senmag-robotics/Mantis-Desktop/partsList.ods

Part reference | Quantity | Description | Self-procurement method | Procurement details | Material | Source (Github) | Link
Motor | 3 | Brushless DC Motor. Produces Torque | Purchase (Link) | Ali express, X8308S | NA | None | https://senmag-robotics.com/mantis/mantis-desktop/partlib/motor
Encoder | 3 | Measures the angle of a magnet | Manufacture PCB (source) and purchase Encoder chip (Link) | Info in source location | NA | TBA | https://senmag-robotics.com/mantis/mantis-desktop/partlib/encoder
Encoder magnet | 3 | Attached to motor, allows encoder to measure angle of motor. | 3D print (source) and add magnets (Link) | Layer height = 0.1mm | PLA | Source/CAD/encoderMagnet.stl | https://senmag-robotics.com/mantis/mantis-desktop/partlib/encodermagnet
Main controller | 1 | Main electronic controller | Manufacture PCB (source) | Info in source location |  | TBA
Sensor Controller | 1 | Electronic controller for the force sensor | Manufacture PCB (source) | Info in source location |  | TBA
Force sensor | 1 | Force sensor – measures force output in 3D | Manufacture PCB (source) | Info in source location |  | TBA
Bolt M3 15mm countersunk | 15 |  | Purchase (Link)
Bolt M3 15mm Cap | 20 |  | Purchase (Link)
Bolt M3 22mm countersunk | 4 |  | Purchase (Link)
Bolt M4 10mm Cap | 6 |  | Purchase (Link)
Bolt M4 16mm Cap | 18 |  | Purchase (Link)
Bolt M4 12mm countersunk | 3 |  | Purchase (Link)
Bolt M4 25mm Cap | 2 |  | Purchase (Link)
Bolt M5 18mm Cap | 3 |  | Purchase (Link)
Nut M3 Nyloc | 12 |  | Purchase (Link)
Nut M4 Nyloc | 2 |  | Purchase (Link)
Nut M5 Nyloc | 3 |  | Purchase (Link)
Part A | 2 | The base sections of the robot, designed to clamp onto a table edge. | 3D print (source) | Layer height = 0.2mm | PLA | Source/CAD/part_a.stl
Part B | 1 | The top panel for the base | Lasercut (source) |  | Steel / Aluminium (3mm) | Source/CAD/part_b.dxf
Part C | 1 | The front panel for the base | Lasercut (source) |  | Delrin 4mm | Source/CAD/part_c.dxf
Part D | 1 | The shoulder pivot bracket | Lasercut + bend (source) |  | Steel / Aluminium (3mm) | Source/CAD/part_d.dxf
Part E | 1 | The shoulder section of the arm | Lasercut (source) |  | Delrin / Acrylic 8mm | Source/CAD/part_e.dxf
Part F | 1 | The first stiffening brace for part E | Lasercut (source) |  | Delrin / Acrylic 8mm | Source/CAD/part_f.dxf
Part G | 1 | The second stiffening brace for pare E | Lasercut (source) |  | Delrin / Acrylic 8mm | Source/CAD/part_g.dxf
Part H | 1 | The elbow section of the arm | Lasercut (source) |  | Delrin / Acrylic 6mm | Source/CAD/part_h.dxf
Part I | 1 | The parallel link section of the arm | Lasercut (source) |  | Delrin / Acrylic 6mm | Source/CAD/part_i.dxf
Part J | 1 | The end section of the arm | Lasercut (source) |  | Delrin / Acrylic 8mm | Source/CAD/part_j.dxf
Part K | 1 | Stiffening brace for part J | Lasercut (source) |  | Delrin / Acrylic 8mm | Source/CAD/part_k.dxf
Part L | 1 | Attachment for the force sensor | 3D print (source) | Layer height = 0.2mm | PLA | Source/CAD/part_l.stl
Part M | 2 | Washer plate for the force sensor | Lasercut (source) |  | Delrin 2mm | Source/CAD/part_m.dxf
Part N | 6 | Washer plate for the force sensor | Lasercut (source) |  | Delrin 2mm | Source/CAD/part_n.dxf
Part O | 1 | End cap of the force sensor | 3D print (source) | Layer height = 0.2mm | PLA | Source/CAD/part_o.stl
Part P | 1 | Centre pin to make axle between motors | Purchase (Link) or Lathe (source) |  | Steel / Aluminium | Source/CAD/part_p.dxf | https://senmag-robotics.com/mantis/mantis-desktop/partlib/centrepin
Part Q | 1 | The panel that the main controller is attached to | Lasercut (source) |  | Delrin 4mm | Source/CAD/part_q.dxf
Part R | 3 | Spacer for the encoders | Lasercut (source) |  | Delrin 4mm | Source/CAD/part_r.dxf
