senmag-robotics/Mantis-Desktop/Source/CAD/part_e.dxf

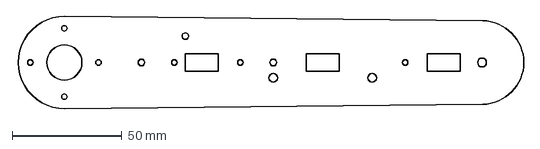
[picture p1: CAD file, 2019-07-10]
Source/CAD/part_e.dxf
231.0 x 42.2 mm
