senmag-robotics/Mantis-Desktop/Source/CAD/part_h.dxf

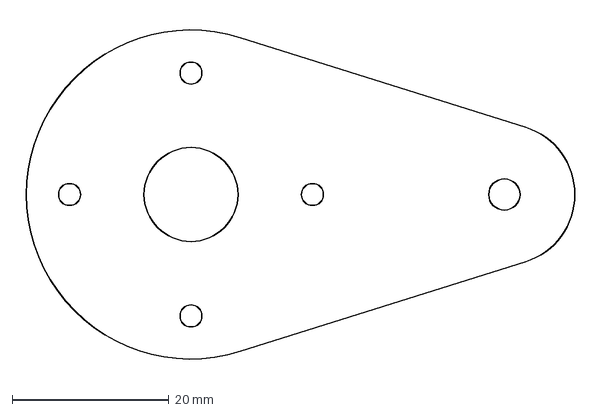
[picture p2: CAD file, 2019-07-10]
Source/CAD/part_h.dxf
71.3 x 45.5 mm
