senmag-robotics/Mantis-Desktop/Source/CAD/part_g.dxf

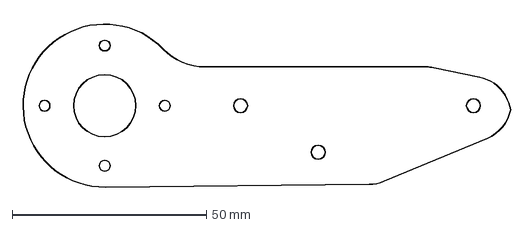
[picture p3: CAD file, 2019-07-10]
Source/CAD/part_g.dxf
127.4 x 44.1 mm
