senmag-robotics/Mantis-Desktop/Source/CAD/part_n.dxf

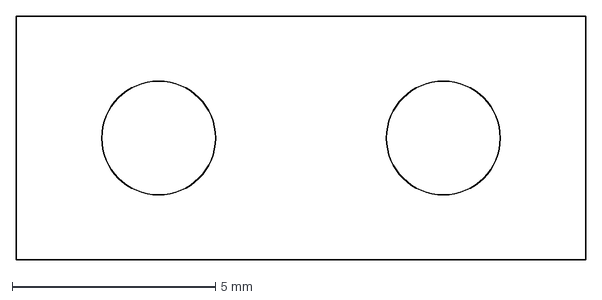
[picture p4: CAD file, 2019-07-10]
Source/CAD/part_n.dxf
14.0 x 6.00 mm
