senmag-robotics/Mantis-Desktop/Source/CAD/part_p.dxf

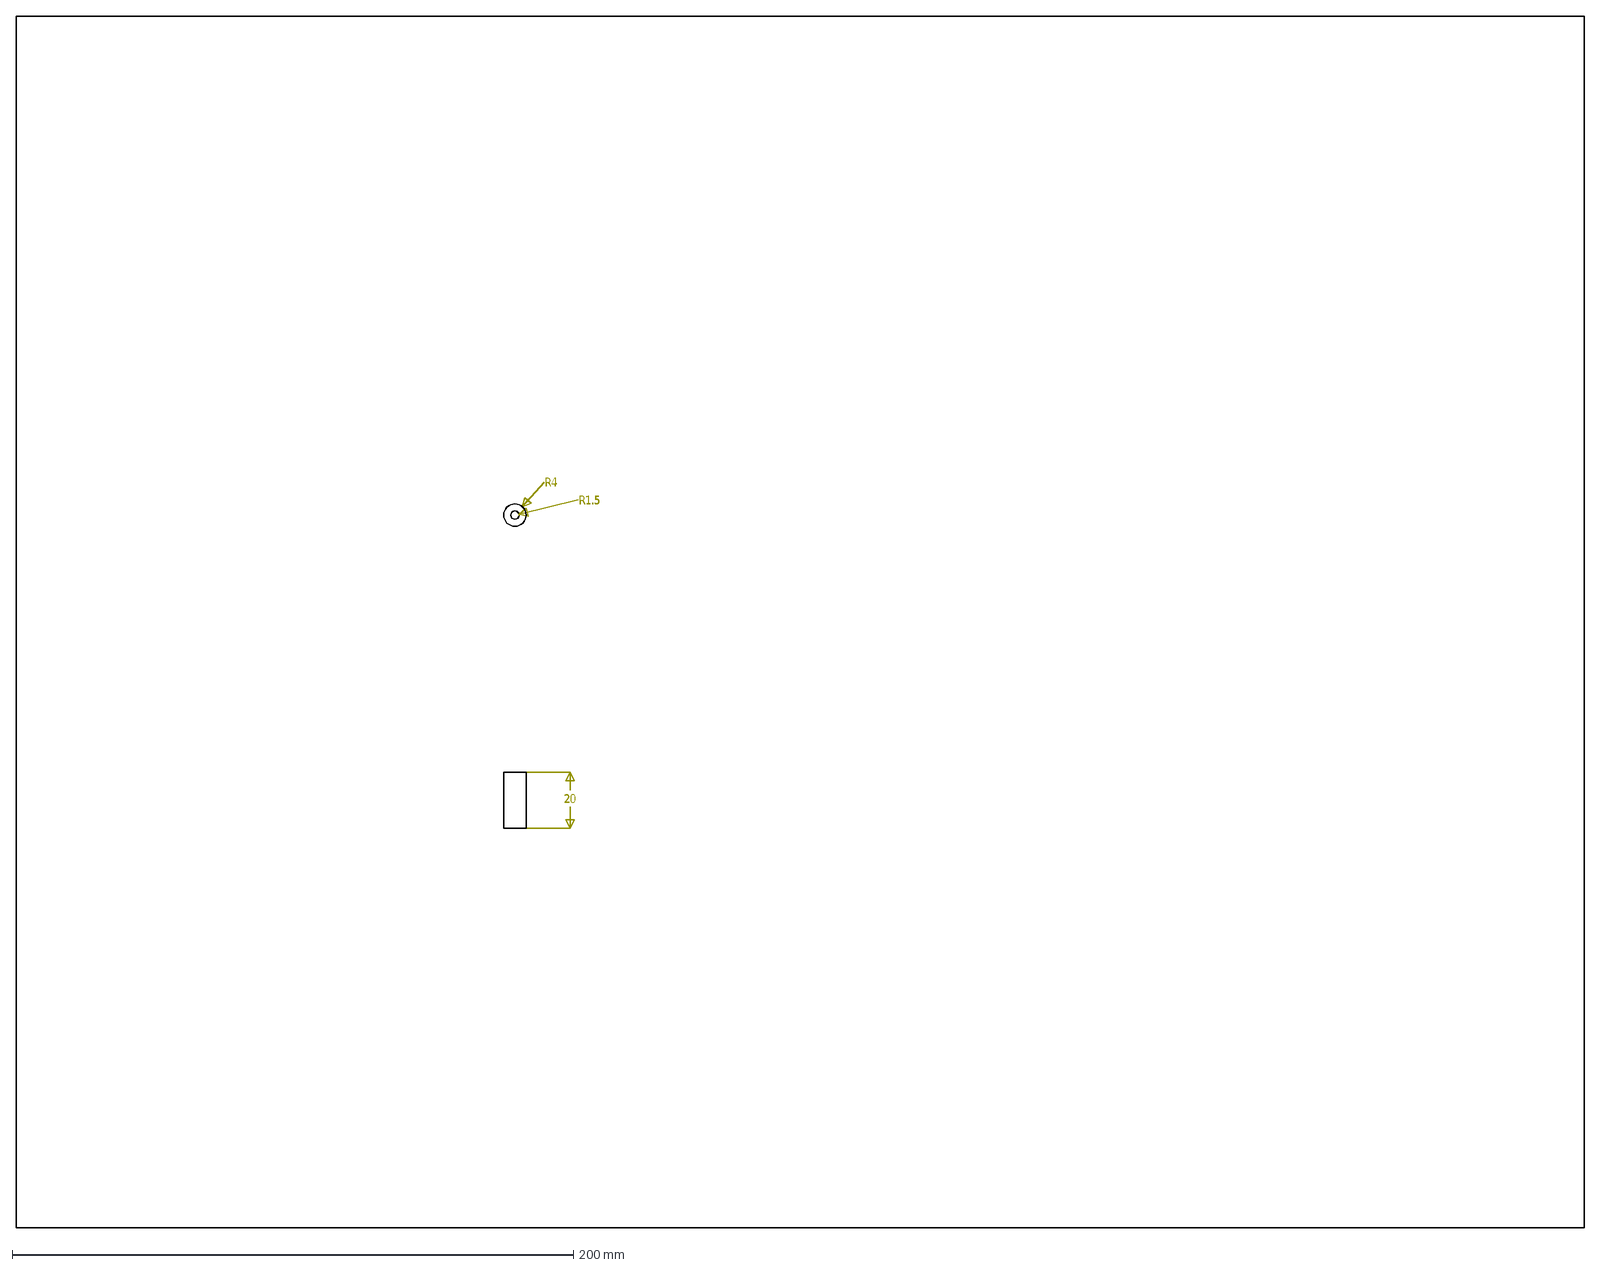
[picture p5: CAD file, 2019-07-10]
Source/CAD/part_p.dxf
R4
R1.5
20
