senmag-robotics/Mantis-Desktop/Source/CAD/part_f.dxf

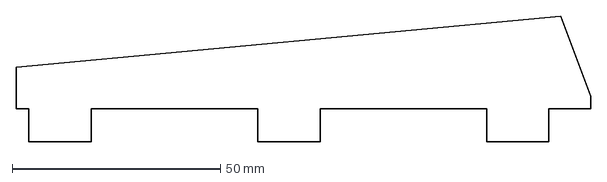
[picture p6: CAD file, 2019-07-10]
Source/CAD/part_f.dxf
138.0 x 30.3 mm
