senmag-robotics/Mantis-Desktop/Source/CAD/part_c.dxf

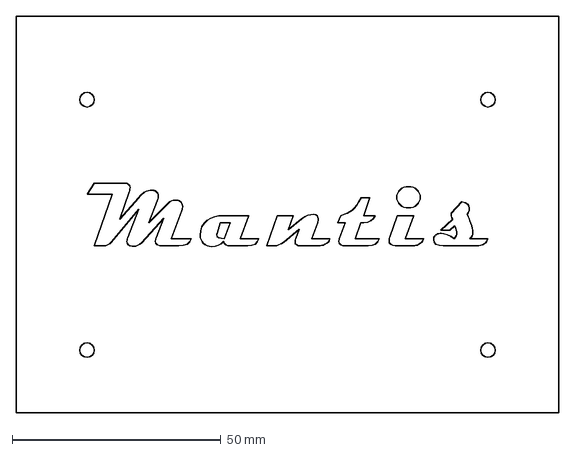
[picture p7: CAD file, 2019-07-10]
Source/CAD/part_c.dxf
130.0 x 95.0 mm
