senmag-robotics/Mantis-Desktop/Source/CAD/part_o.stl

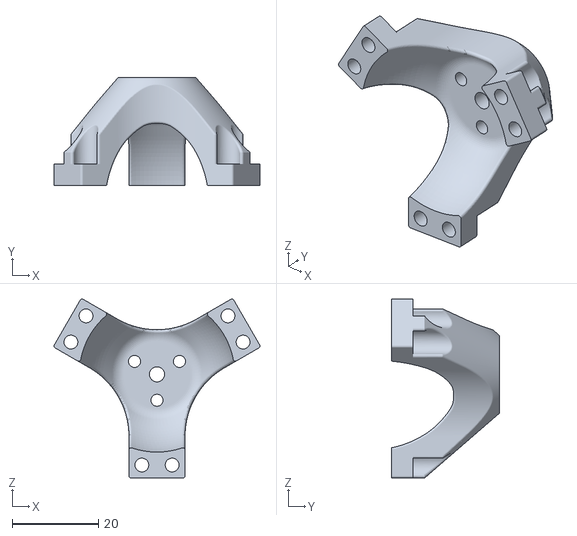
[picture p8: CAD file, 2019-07-10]
Source/CAD/part_o.stl
47.7 x 25.0 x 41.4
