senmag-robotics/Mantis-Desktop/Source/CAD/part_r.dxf

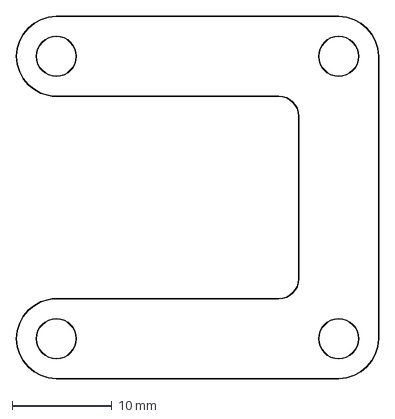
[picture p9: CAD file, 2019-07-10]
Source/CAD/part_r.dxf
36.3 x 36.3 mm
