senmag-robotics/Mantis-Desktop/Source/CAD/part_b.dxf

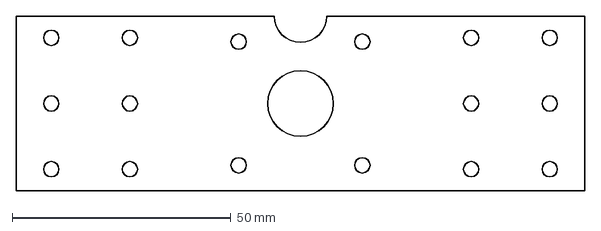
[picture p10: CAD file, 2019-07-10]
Source/CAD/part_b.dxf
130.0 x 40.0 mm
