senmag-robotics/Mantis-Desktop/Source/CAD/part_i.dxf

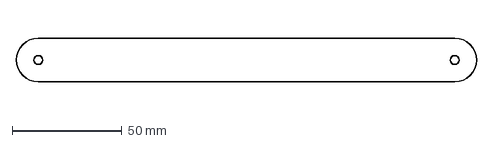
[picture p11: CAD file, 2019-07-10]
Source/CAD/part_i.dxf
210.0 x 20.0 mm
