senmag-robotics/Mantis-Desktop/Source/CAD/part_j.dxf

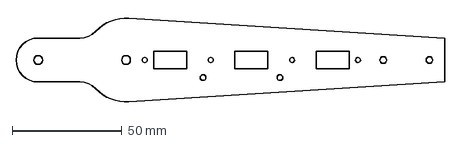
[picture p12: CAD file, 2019-07-10]
Source/CAD/part_j.dxf
195.0 x 38.6 mm
