senmag-robotics/Mantis-Desktop/Source/CAD/encodermagnet.stl

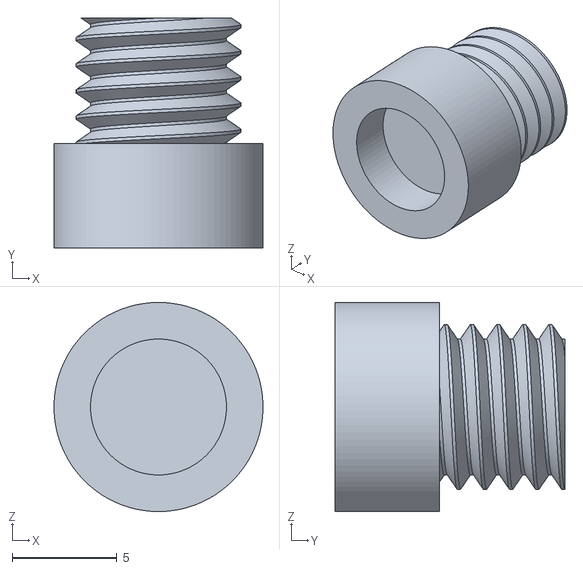
[picture p13: CAD file, 2019-07-10]
Source/CAD/encodermagnet.stl
9.99 x 11.0 x 10.0
