senmag-robotics/Mantis-Desktop/Source/CAD/part_k.dxf

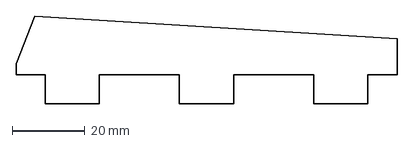
[picture p14: CAD file, 2019-07-10]
Source/CAD/part_k.dxf
105.0 x 24.2 mm
