senmag-robotics/Mantis-Desktop/Source/CAD/part_l.stl

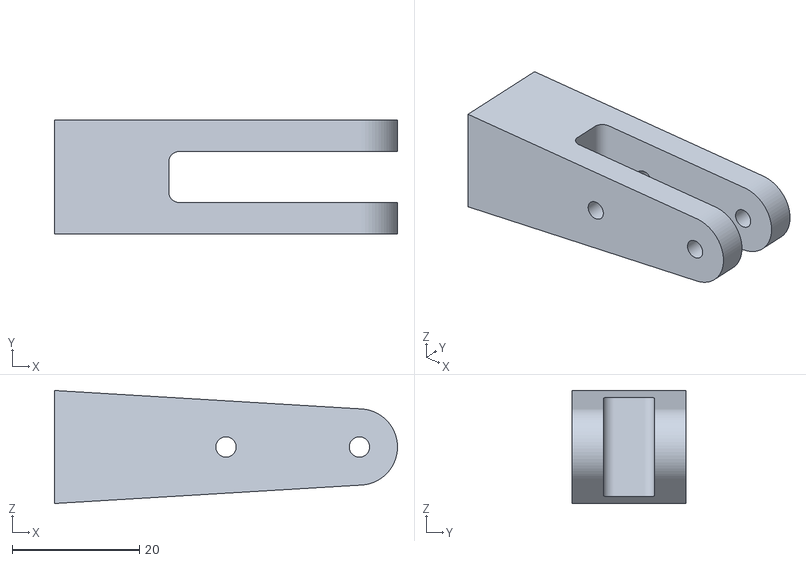
[picture p15: CAD file, 2019-07-10]
Source/CAD/part_l.stl
54.0 x 18.0 x 17.8
