senmag-robotics/Mantis-Desktop/Source/CAD/part_m.dxf

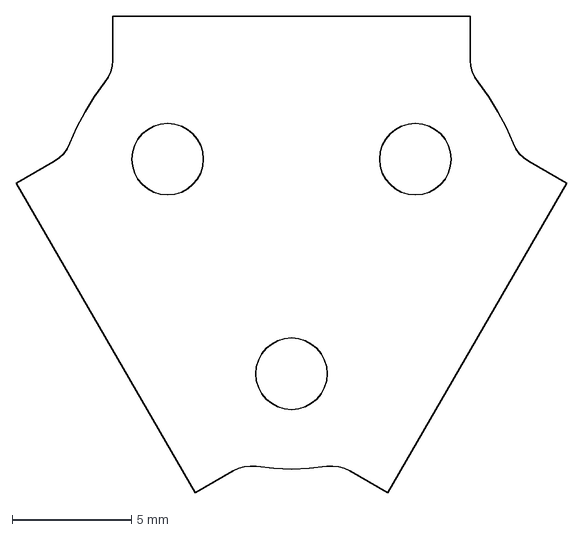
[picture p16: CAD file, 2019-07-10]
Source/CAD/part_m.dxf
23.1 x 20.0 mm
