senmag-robotics/Mantis-Desktop/Source/CAD/part_a.stl

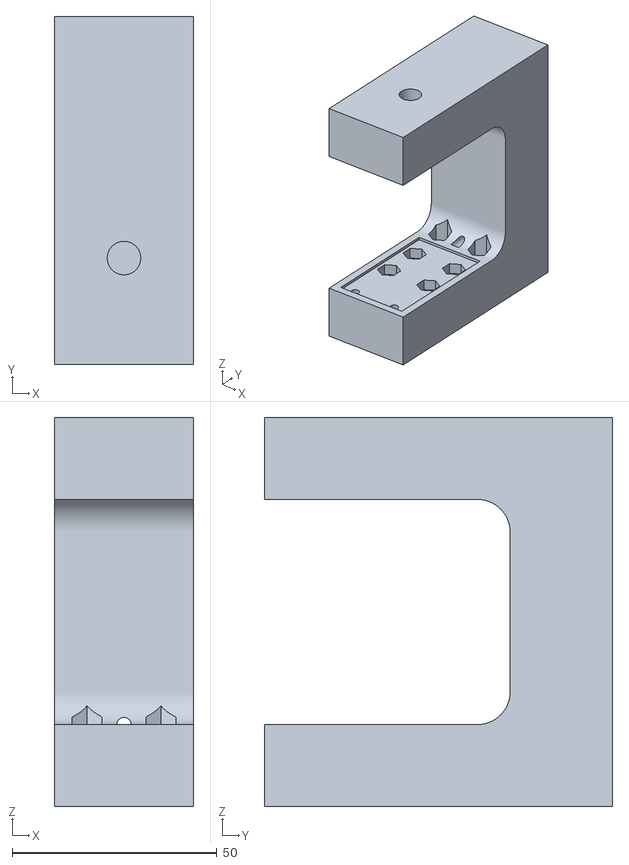
[picture p17: CAD file, 2019-07-10]
Source/CAD/part_a.stl
34.0 x 85.0 x 95.0
