senmag-robotics/Mantis-Desktop/Source/CAD/part_d.dxf

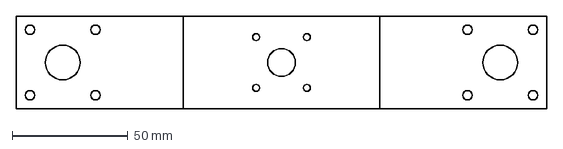
[picture p18: CAD file, 2019-07-10]
Source/CAD/part_d.dxf
229.0 x 40.0 mm
