senmag-robotics/Mantis-Desktop/MantisDesktop_AssembleyGuide.pdf

# Mantis Desktop Assembly Guide

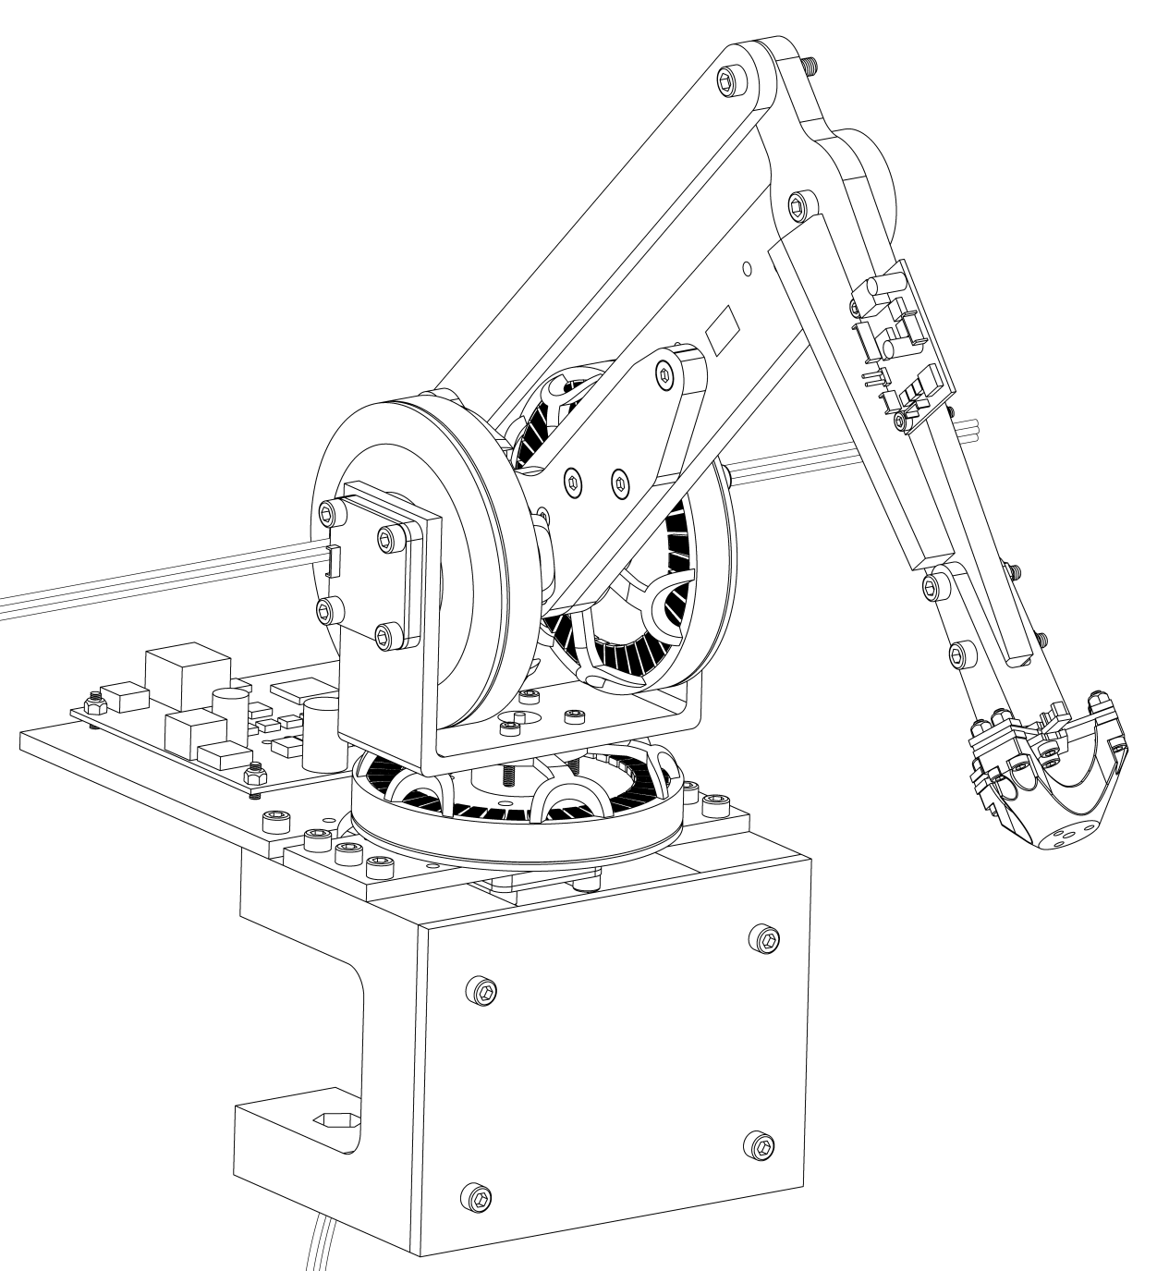
[picture p19: figure]

# Version 1.0

Written by Gareth Barnaby

## Table of Contents

## Introduction:

This document contains instructions for assembling the open source Mantis desktop haptic robot. The most recent version of this document along with the source materials can be found on our GitHub: (https://github.com/senmag-robotics/Mantis-Desktop/).

This document contains visual instructions for assembling a Mantis desktop from pre-fabricated parts. General information on fabricating / purchasing the necessary parts can be found in the “PartFabrication.ods” file in the GitHub, and more detailed information including CAD files can be found in the Source/CAD folder.

The next section in this document is the part index. This lists all of the major components needed to assemble the mechanics of the Mantis-mini. This is followed by sections of step-by-step instructions to assemble the parts. Connecting the electronics and uploading firmware will be covered by a separate document.

## Part index:

Part reference | Quantity in kit | Description | Image

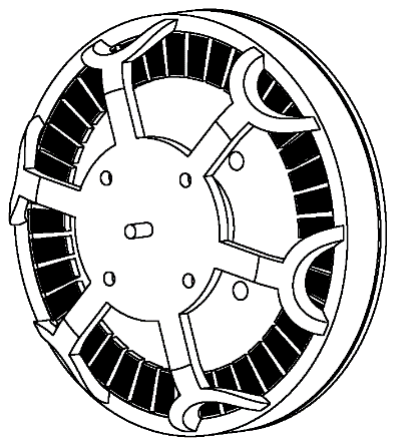
[picture p20: figure]

Motor | 3 | Brushless DC Motor. Produces Torque

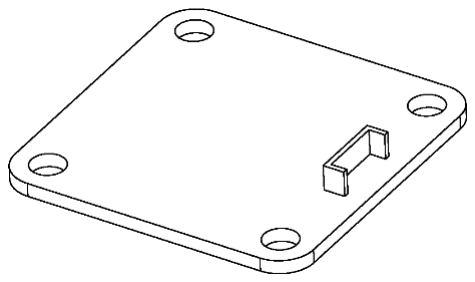
[picture p21: figure]

Encoder | 3 | Measures the angle of a magnet

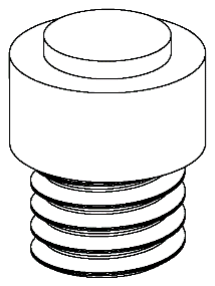
[picture p22: figure]

Encoder Magnet | 3 | Attached to motor, allows encoder to measure angle of motor.

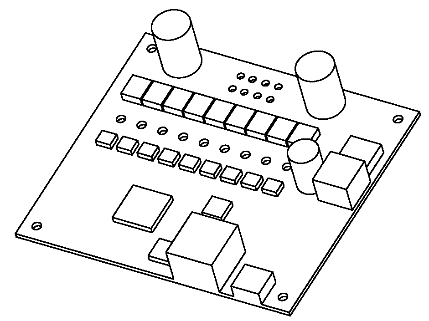
[picture p23: figure]

Main Controller | 1 | Main electronic controller

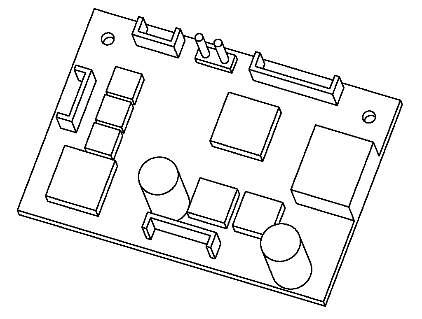
[picture p24: figure]

Sensor Controller | 1 | Electronic controller for the force sensor

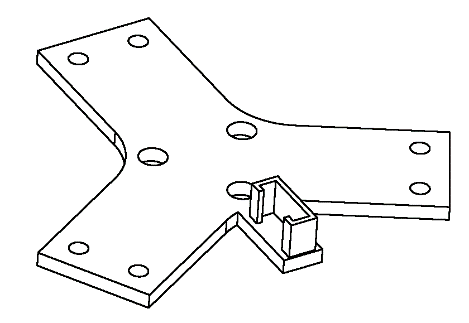
[picture p25: figure]

Force Sensor | 1 | Force sensor – measures force output in 3D
Bolt (M3 15mm countersunk) | 15
Bolt (M3 15mm cap) | 20
Bolt (M3 22mm countersunk) | 4
Bolt (M4 10mm cap) | 6
Bolt (M4 16mm cap) | 18

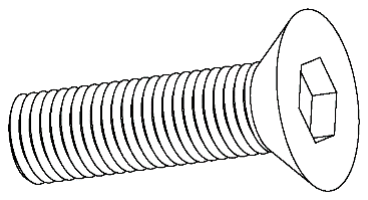
[picture p26: figure]

Bolt (M4 12mm countersunk) | 3

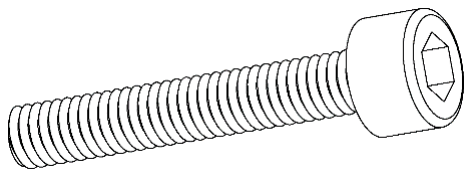
[picture p27: figure]

Bolt (M4 25mm cap) | 2

Bolt (M5 18mm cap) | 3
Nut M3 Nyloc | 12
Nut M4 Nyloc | 2

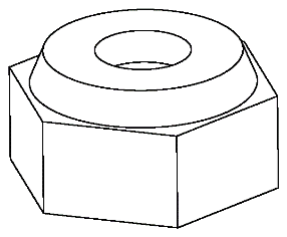
[picture p28: figure]

Nut M5 Nyloc | 3

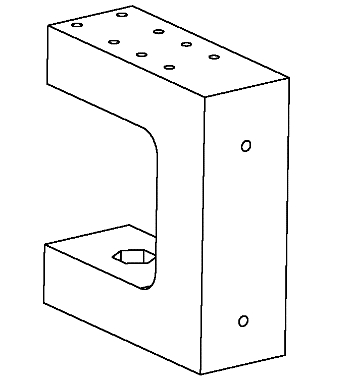
[picture p29: figure]

Part A | 2 | The base sections of the robot, designed to clamp onto a table edge.

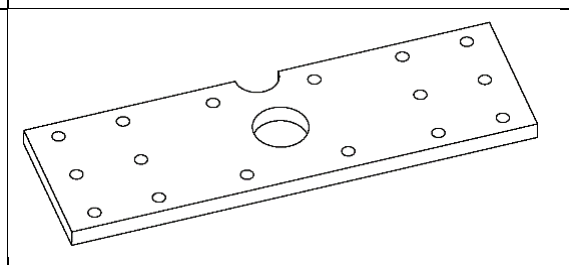
[picture p30: figure]

Part B | 1 | The top panel for the base

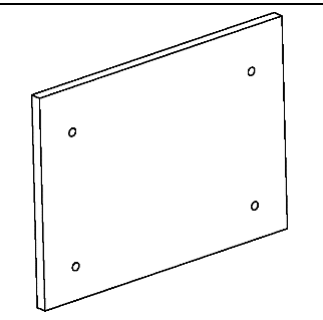
[picture p31: figure]

Part C | 1 | The front panel for the base

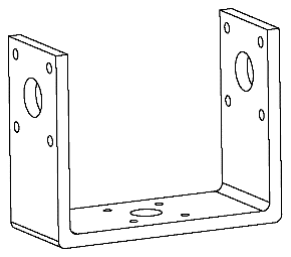
[picture p32: figure]

Part D | 1 | The shoulder pivot bracket

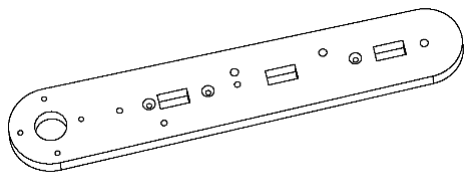
[picture p33: figure]

Part E | 1 | The shoulder section of the arm
Part F | 1 | The first stiffening brace for part E
Part G | 1 | The second stiffening brace for pare E
Part H | 1 | The elbow section of the arm
Part I | 1 | The parallel link section of the arm

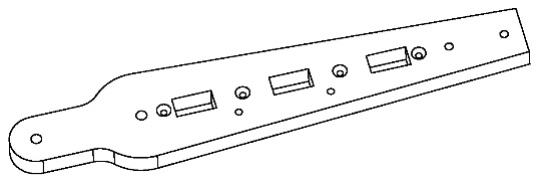
[picture p34: figure]

Part J | 1 | The end section of the arm

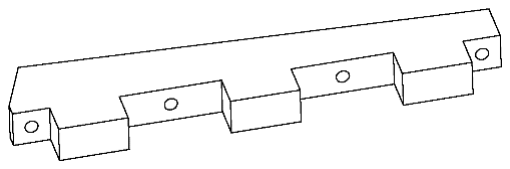
[picture p35: figure]

Part K | 1 | Stiffening brace for part J

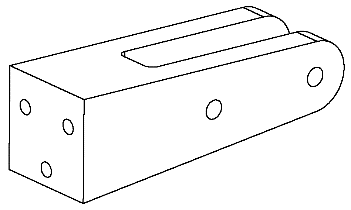
[picture p36: figure]

Part L | 1 | Attachment for the force sensor
Part M | 2 | Washer plate for the force sensor
Part N | 6 | Washer plate for the force sensor

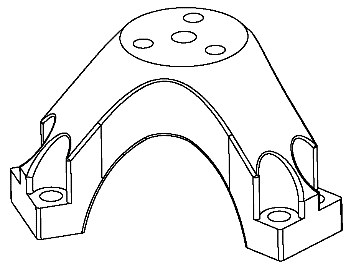
[picture p37: figure]

Part O | 1 | End cap of the force sensor
Part P | 1 | Centre pin to make axle between motors

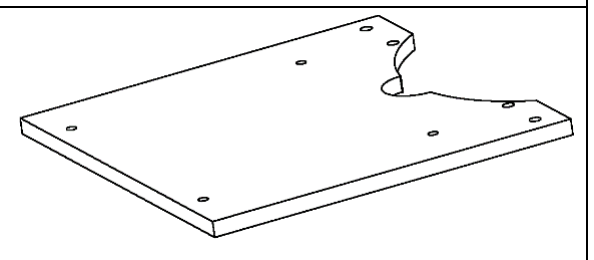
[picture p38: figure]

Part Q | 1 | The panel that the main controller is attached to

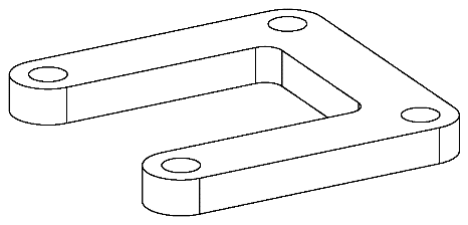
[picture p39: figure]

Part R | 3 | Spacer for the encoders

## Assembly Guide:

### Step 1, attach the arm end brace part

- M3 15mm countersunk (x4)
- Part J
- Part K

Directions:

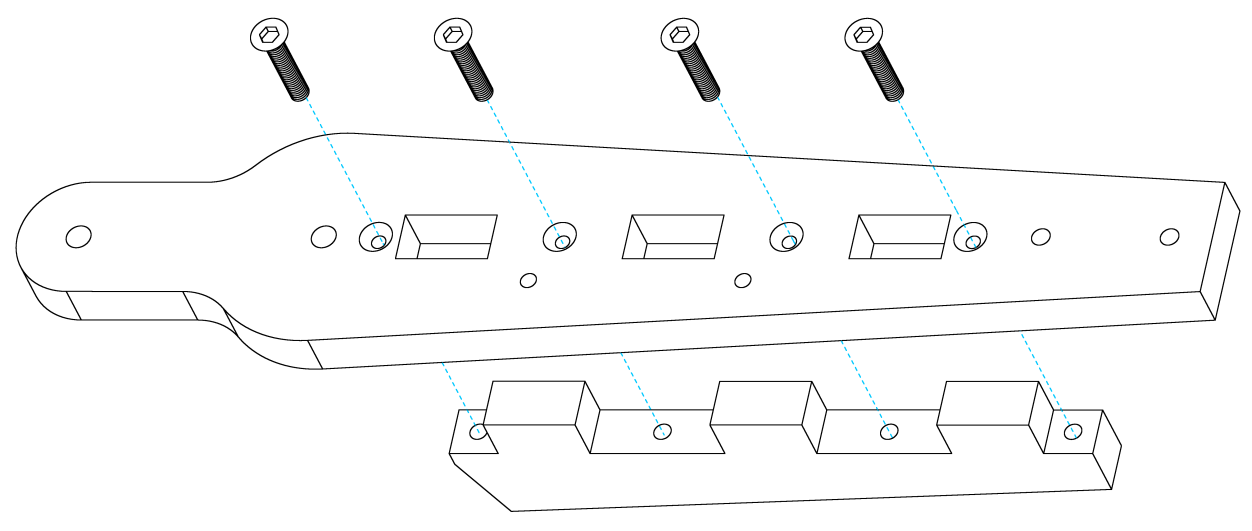
[picture p40: figure]

Finished:

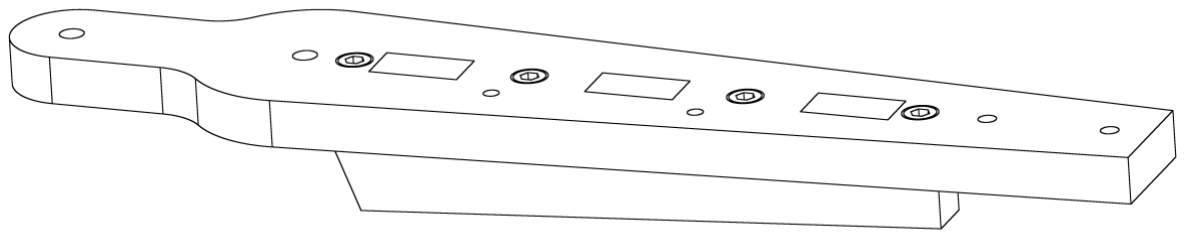
[picture p41: figure]
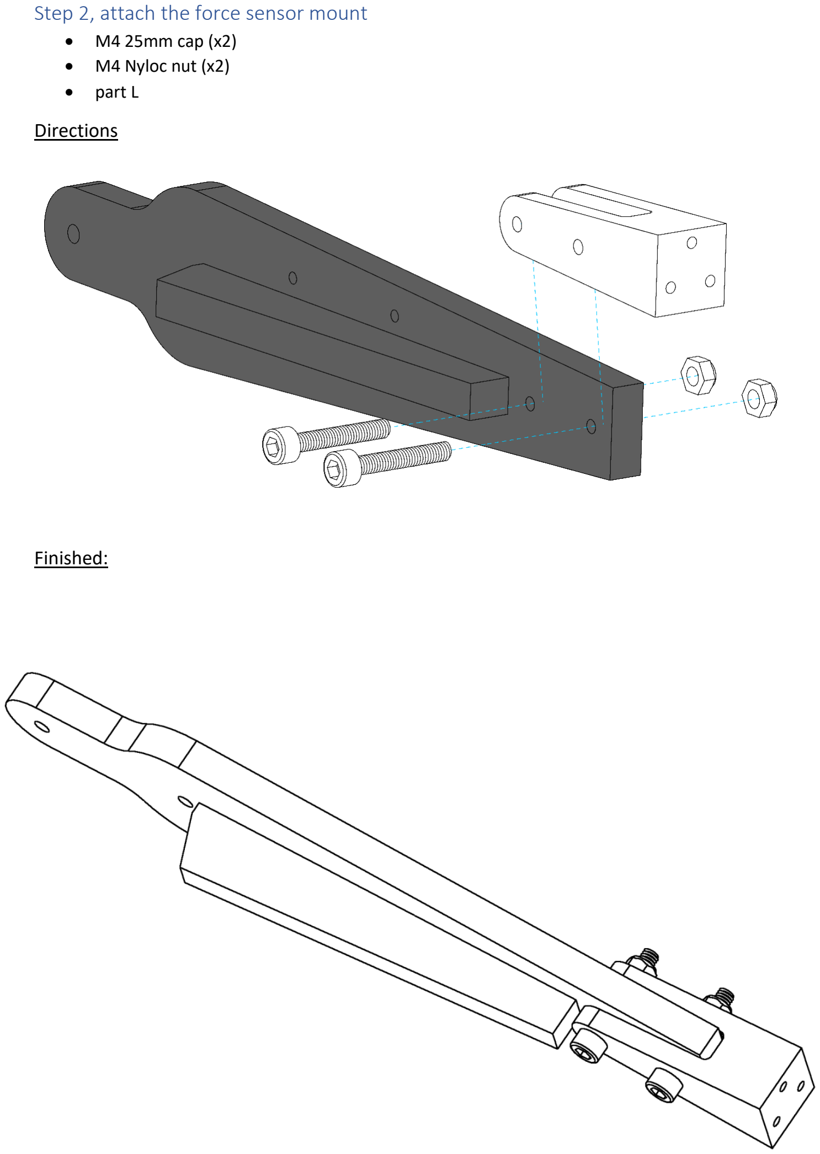
[picture p42: page 9]

### Step 2, attach the force sensor mount

- M4 25mm cap (x2)
- M4 Nyloc nut (x2)
- part L

Directions

Finished:

### Step 3, attach the force sensor

- M3 15mm cap (x3)
- Part M (x2)
- Force sensor

Directions:

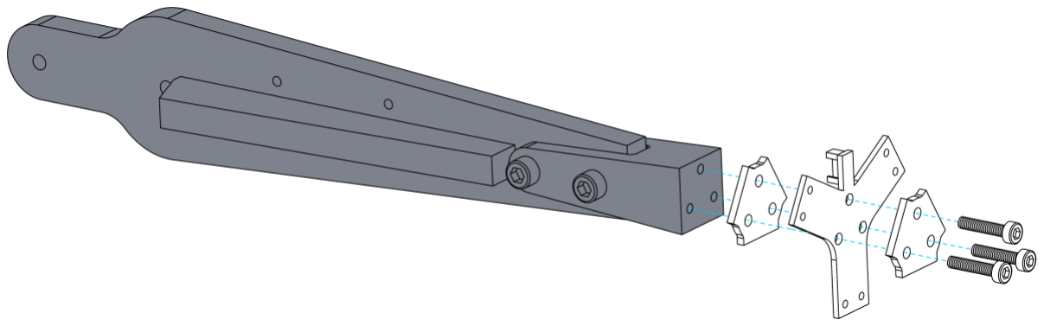
[picture p43: figure]

Finished:

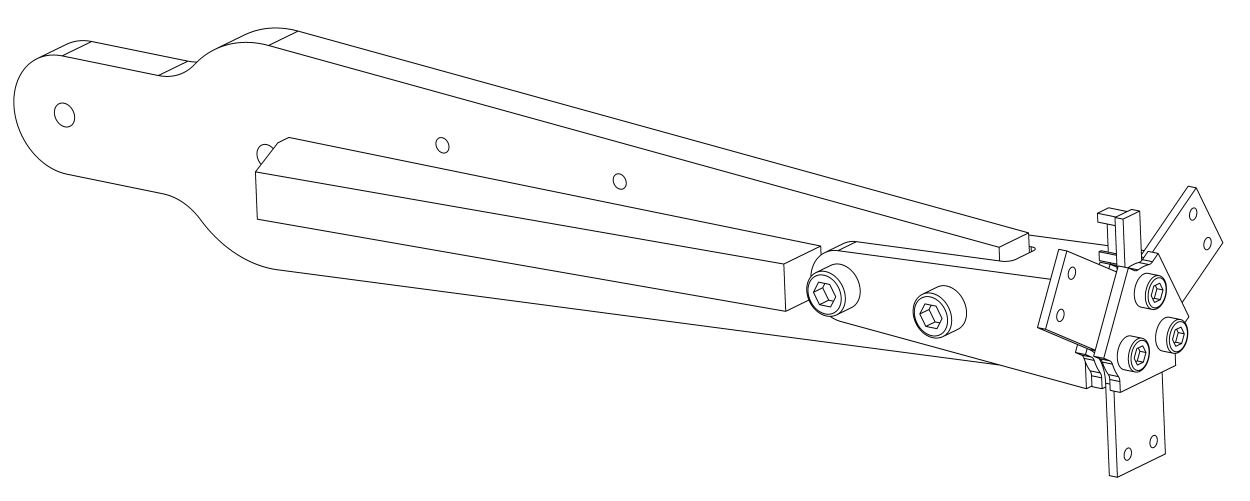
[picture p44: figure]
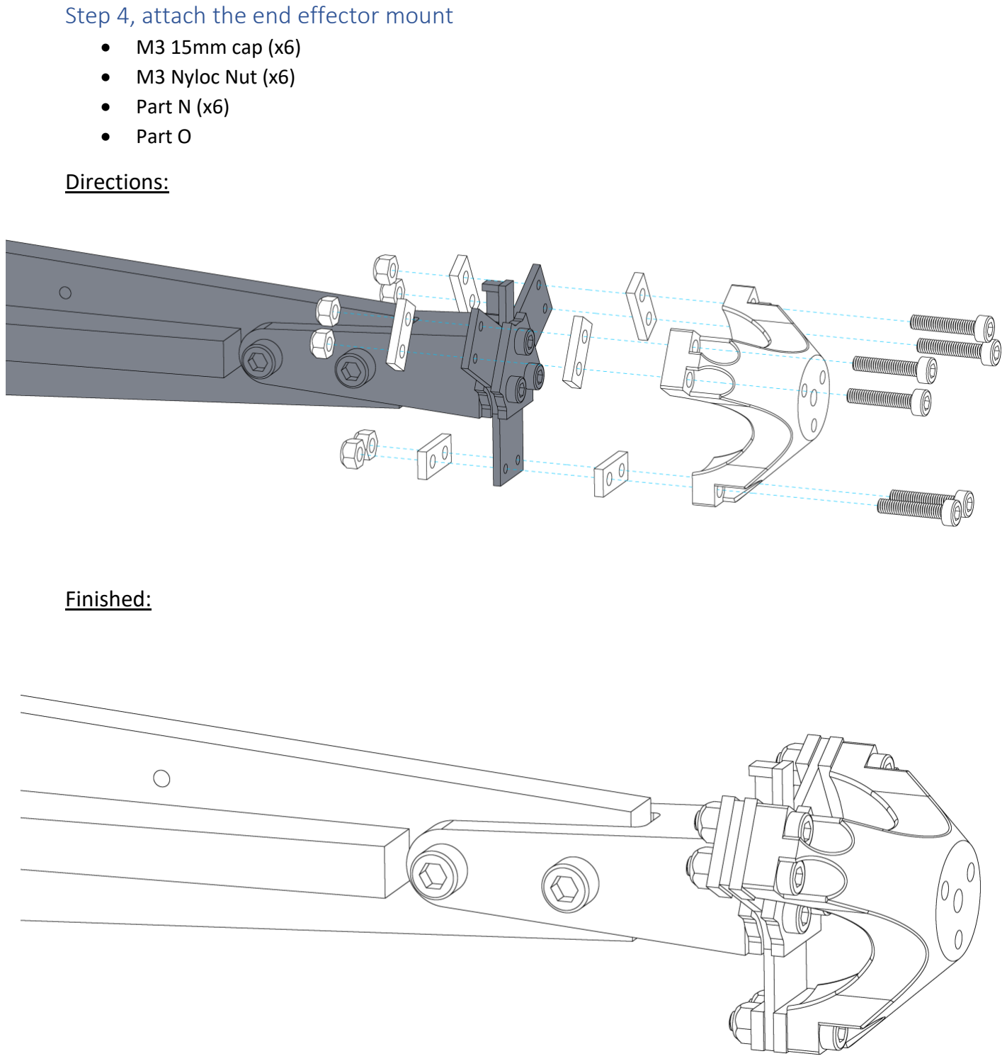
[picture p45: page 11]

### Step 4, attach the end effector mount

- M3 15mm cap (x6)
- M3 Nyloc Nut (x6)
- Part N (x6)
- Part O

Directions:

Finished:

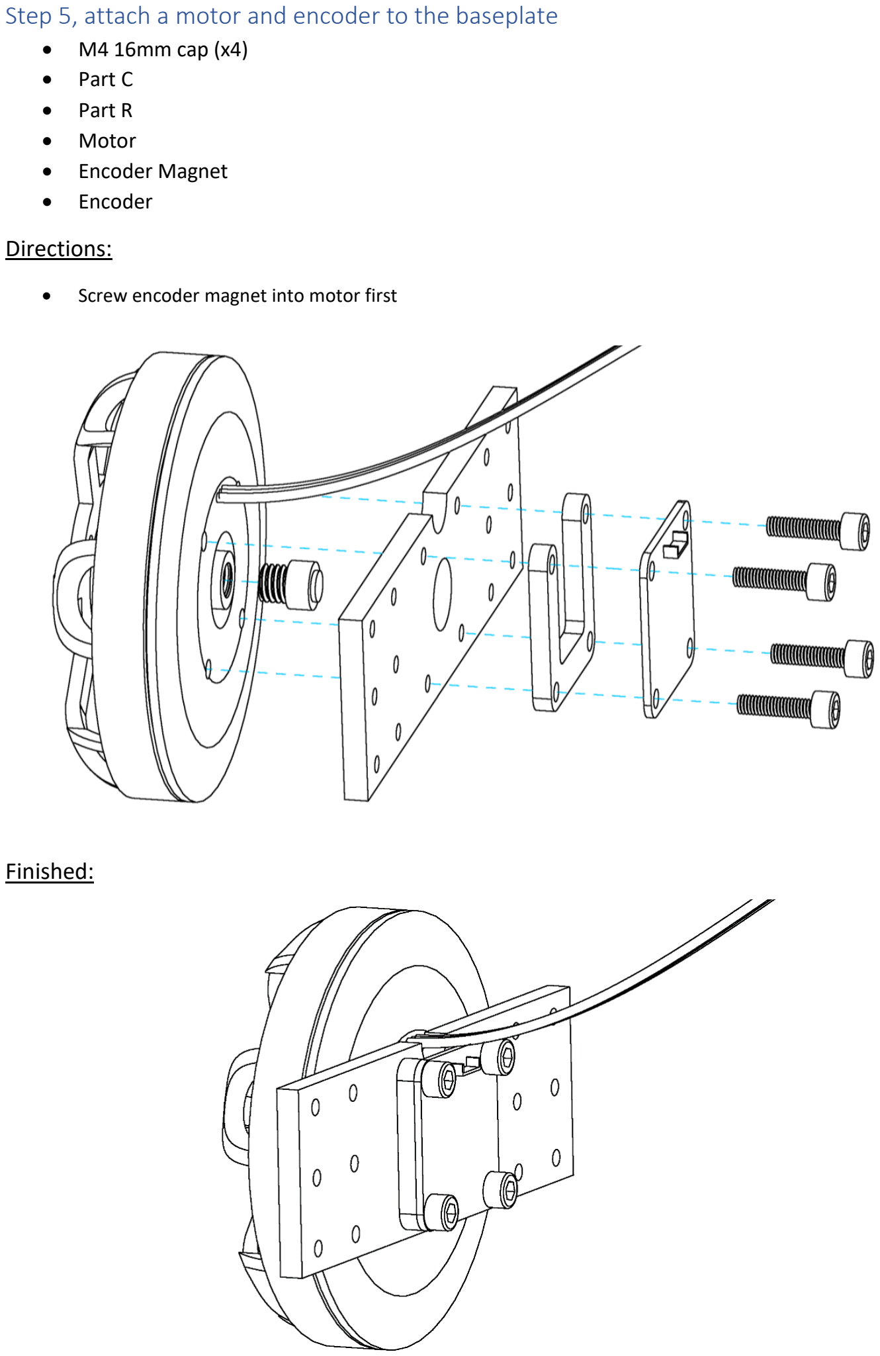
[picture p46: page 12]

### Step 5, attach a motor and encoder to the baseplate

- M4 16mm cap (x4)
- Part C
- Part R
- Motor
- Encoder Magnet
- Encoder

Directions:

- Screw encoder magnet into motor first

Finished:

### Step 6, attach the shoulder bracket to the previous step

- M3 15mm cap (x4)
- Part D

Directions:

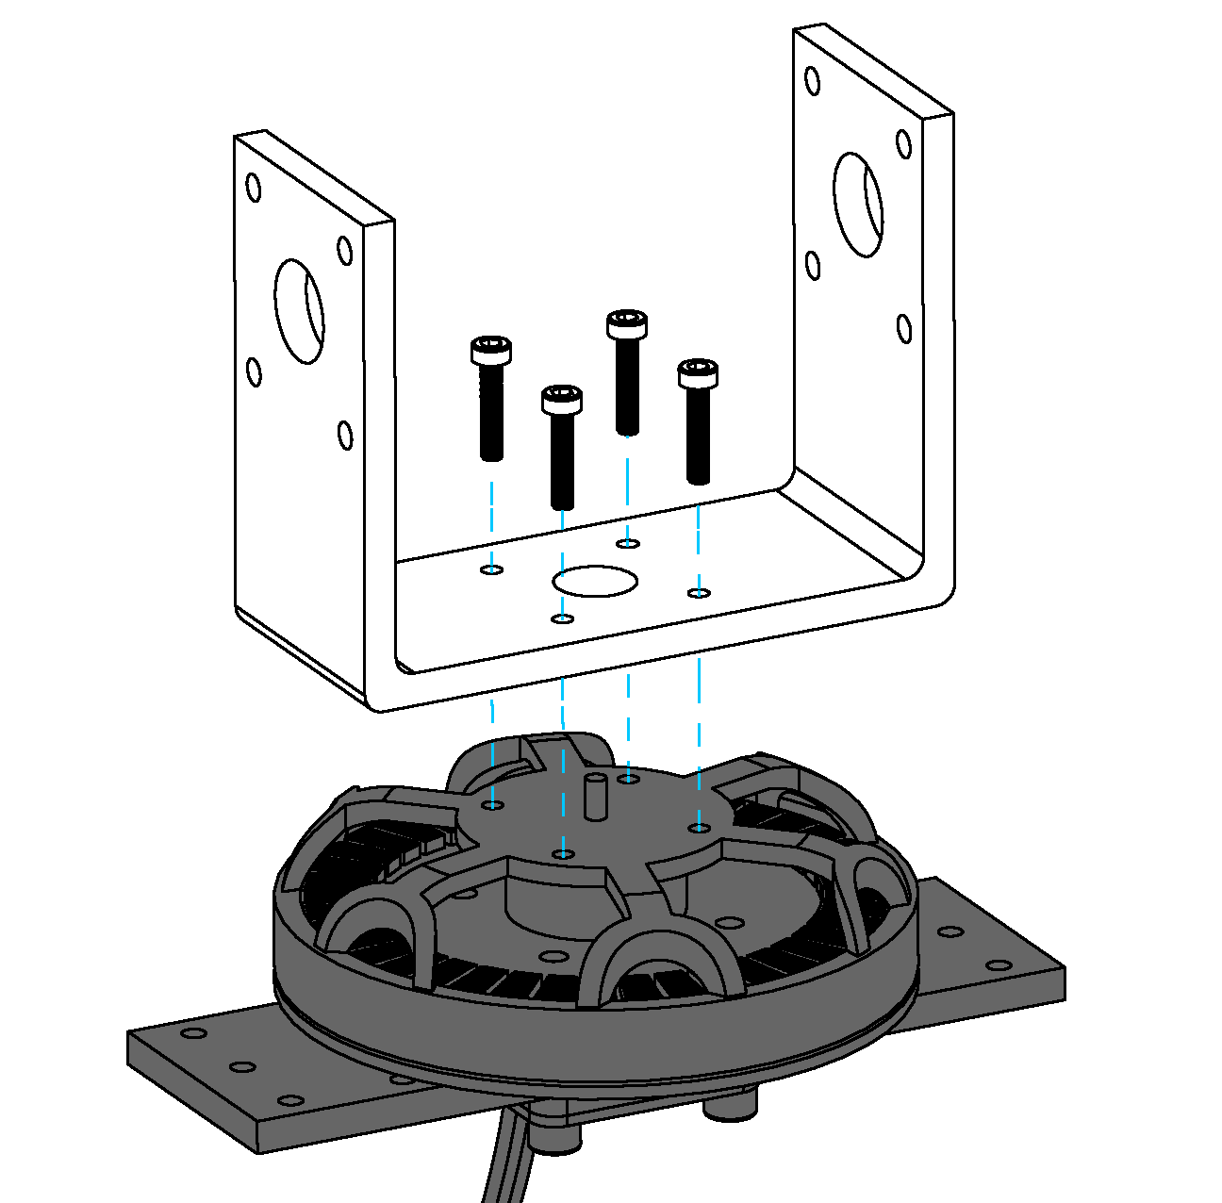
[picture p47: figure]

(Step 6) Finished:

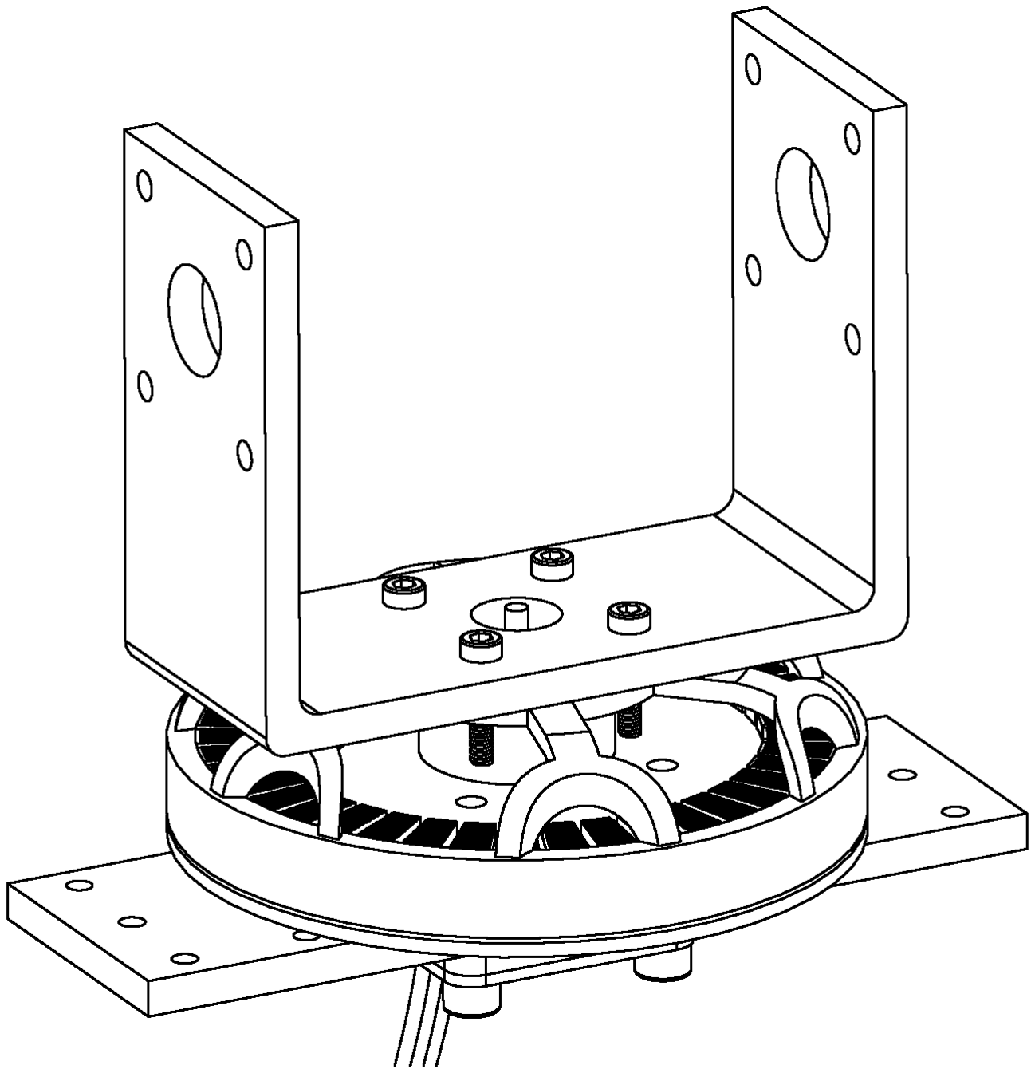
[picture p48: figure]

### Step 7, assemble the base of the robot

- M4 16mm cap (x6)
- M4 10mm cap (x4)
- Part A (x2)
- Part B

Directions:

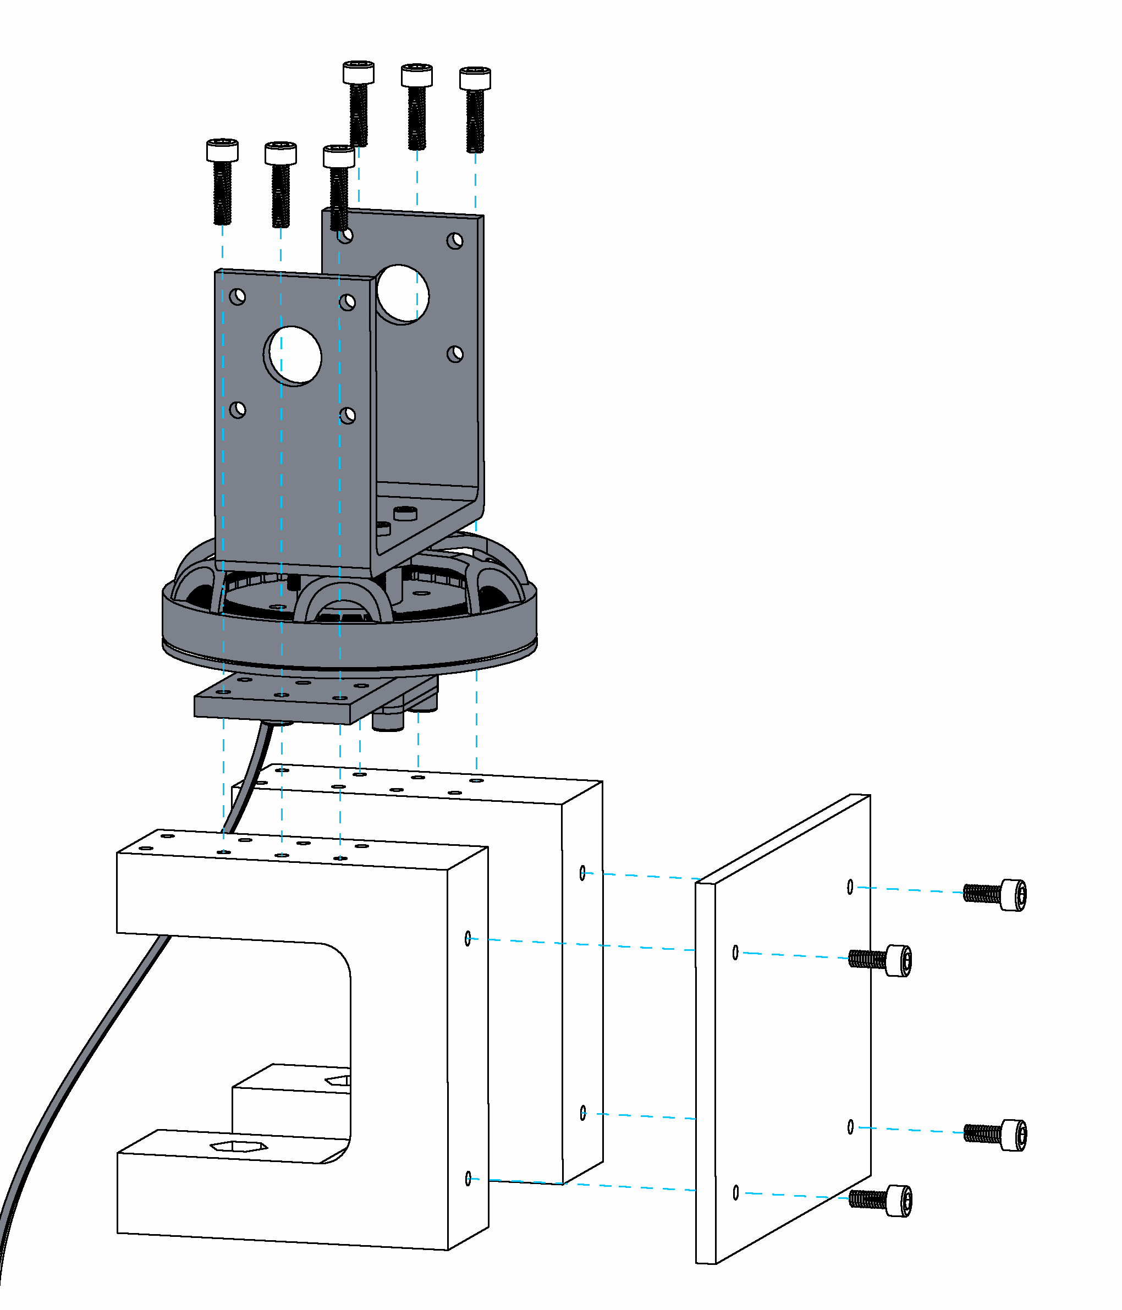
[picture p49: figure]

(Step 7) Finished:

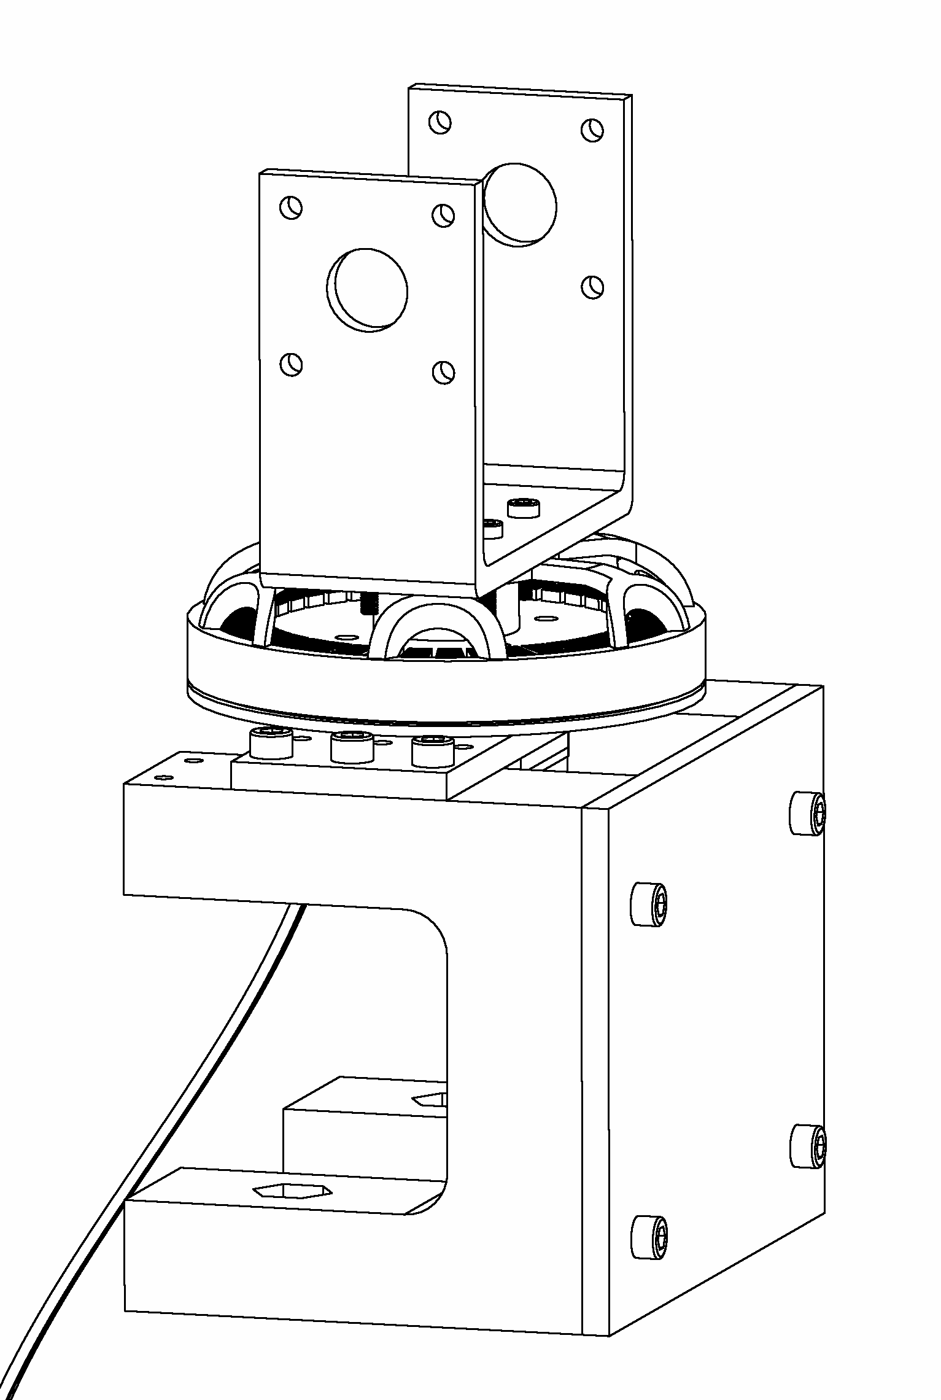
[picture p50: figure]
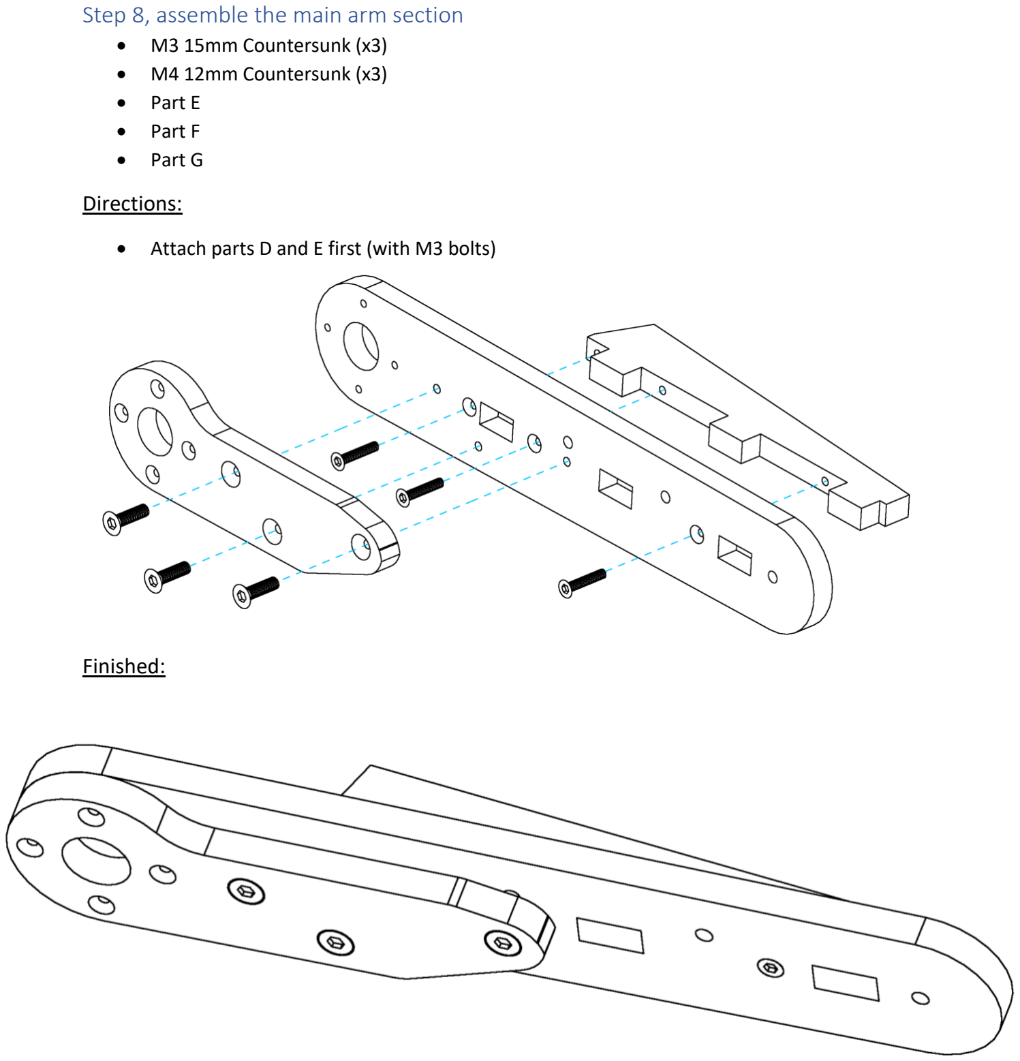
[picture p51: page 17]

### Step 8, assemble the main arm section

- M3 15mm Countersunk (x3)
- M4 12mm Countersunk (x3)
- Part E
- Part F
- Part G

Directions:

- Attach parts D and E first (with M3 bolts)

Finished:

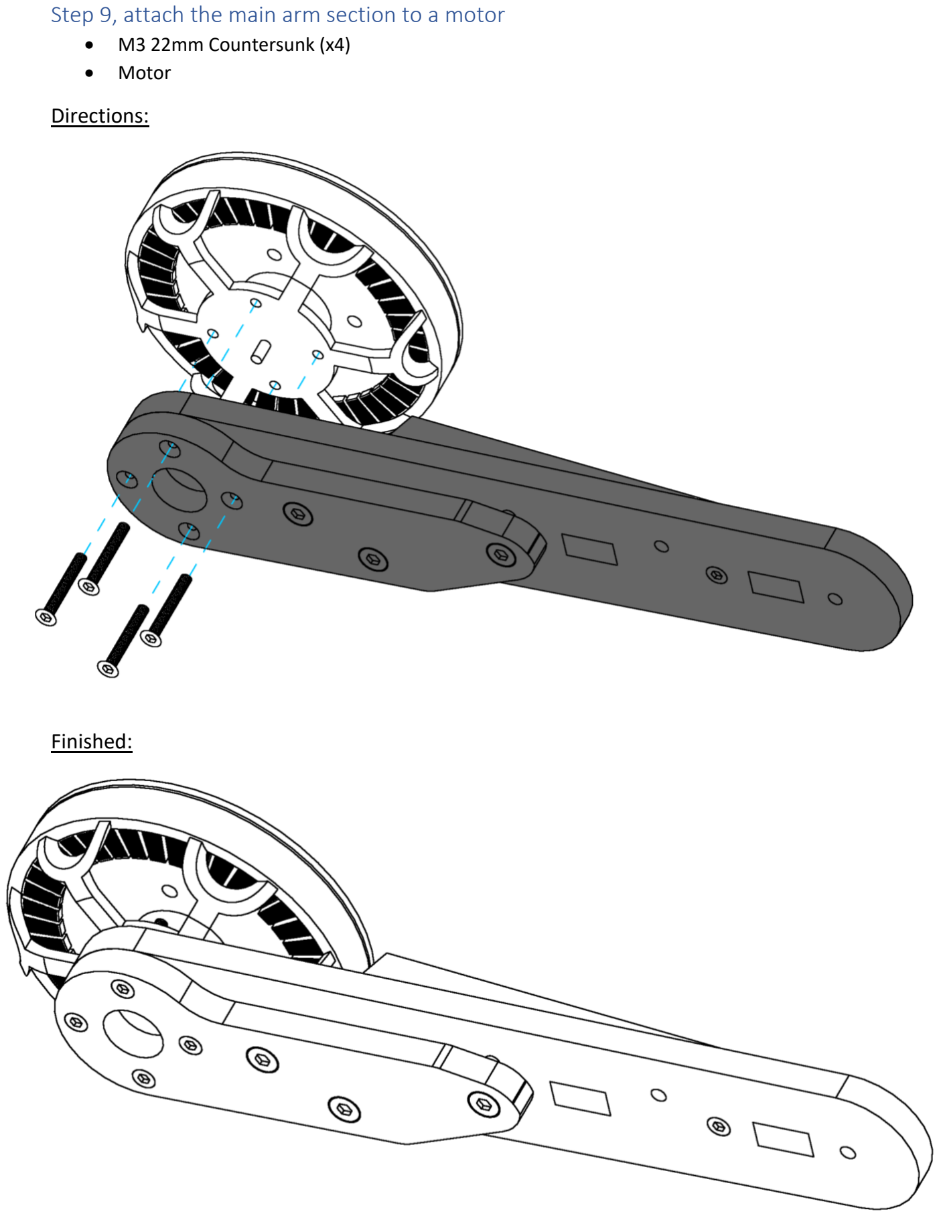
[picture p52: page 18]

### Step 9, attach the main arm section to a motor

- M3 22mm Countersunk (x4)
- Motor

Directions:

Finished:

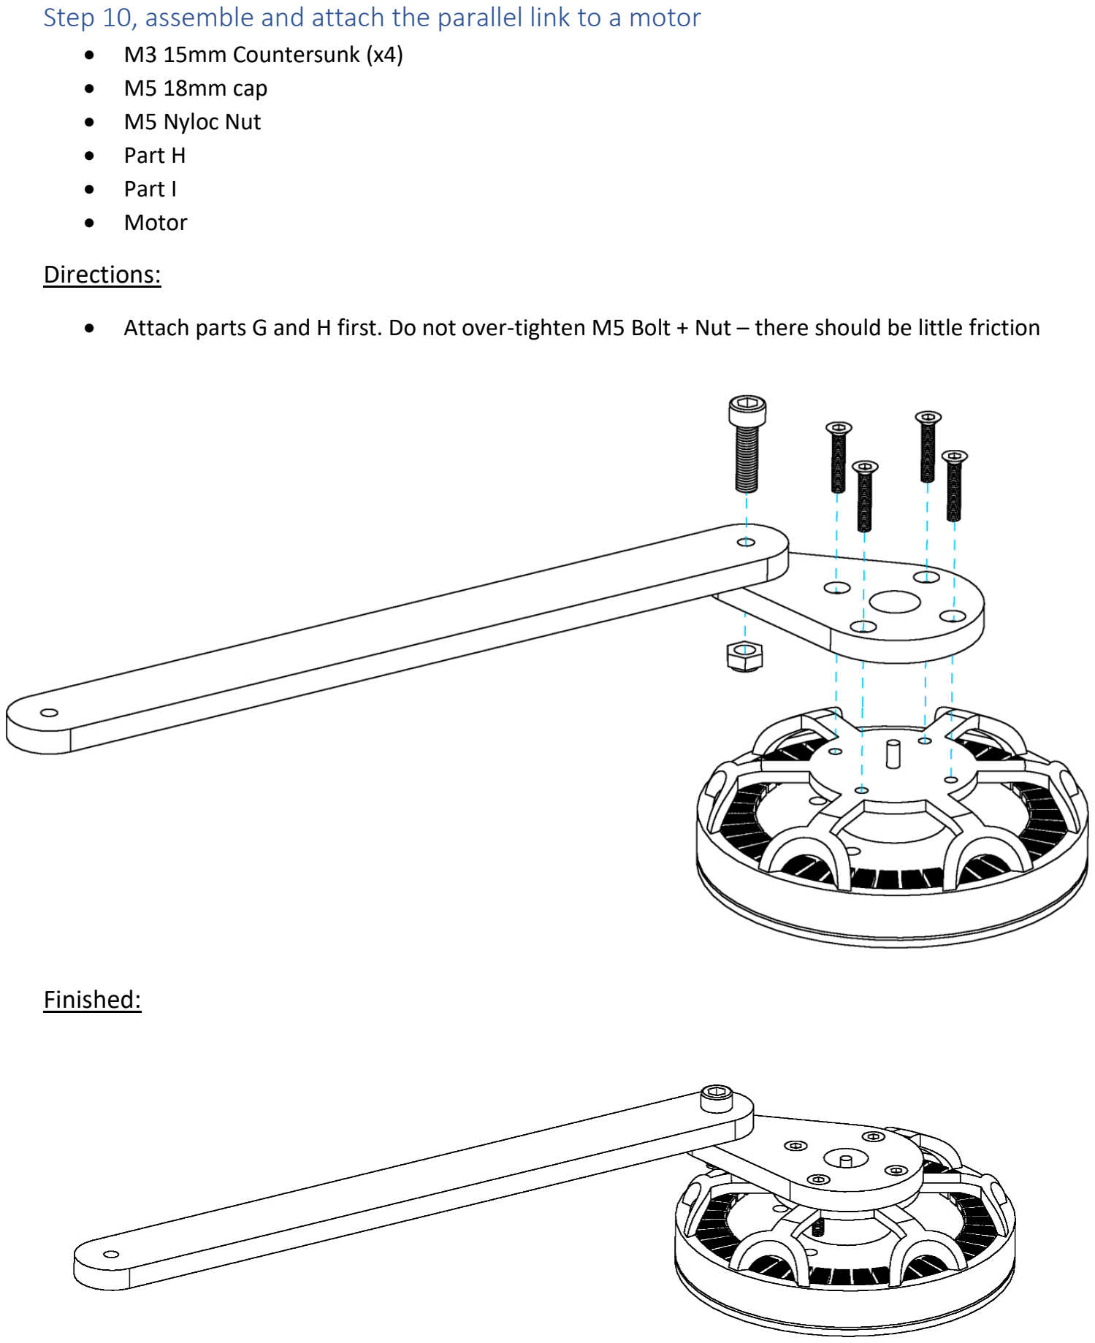
[picture p53: page 19]

### Step 10, assemble and attach the parallel link to a motor

- M3 15mm Countersunk (x4)
- M5 18mm cap
- M5 Nyloc Nut
- Part H
- Part I
- Motor

Directions:

- Attach parts G and H first. Do not over-tighten M5 Bolt + Nut – there should be little friction

Finished:

### Step 11, align both motors within the shoulder bracket

- Part P

Directions:

- Part P should fit over the shaft of each motor. The Motors should then fit snugly into Part D ready to be fastened in step 12.

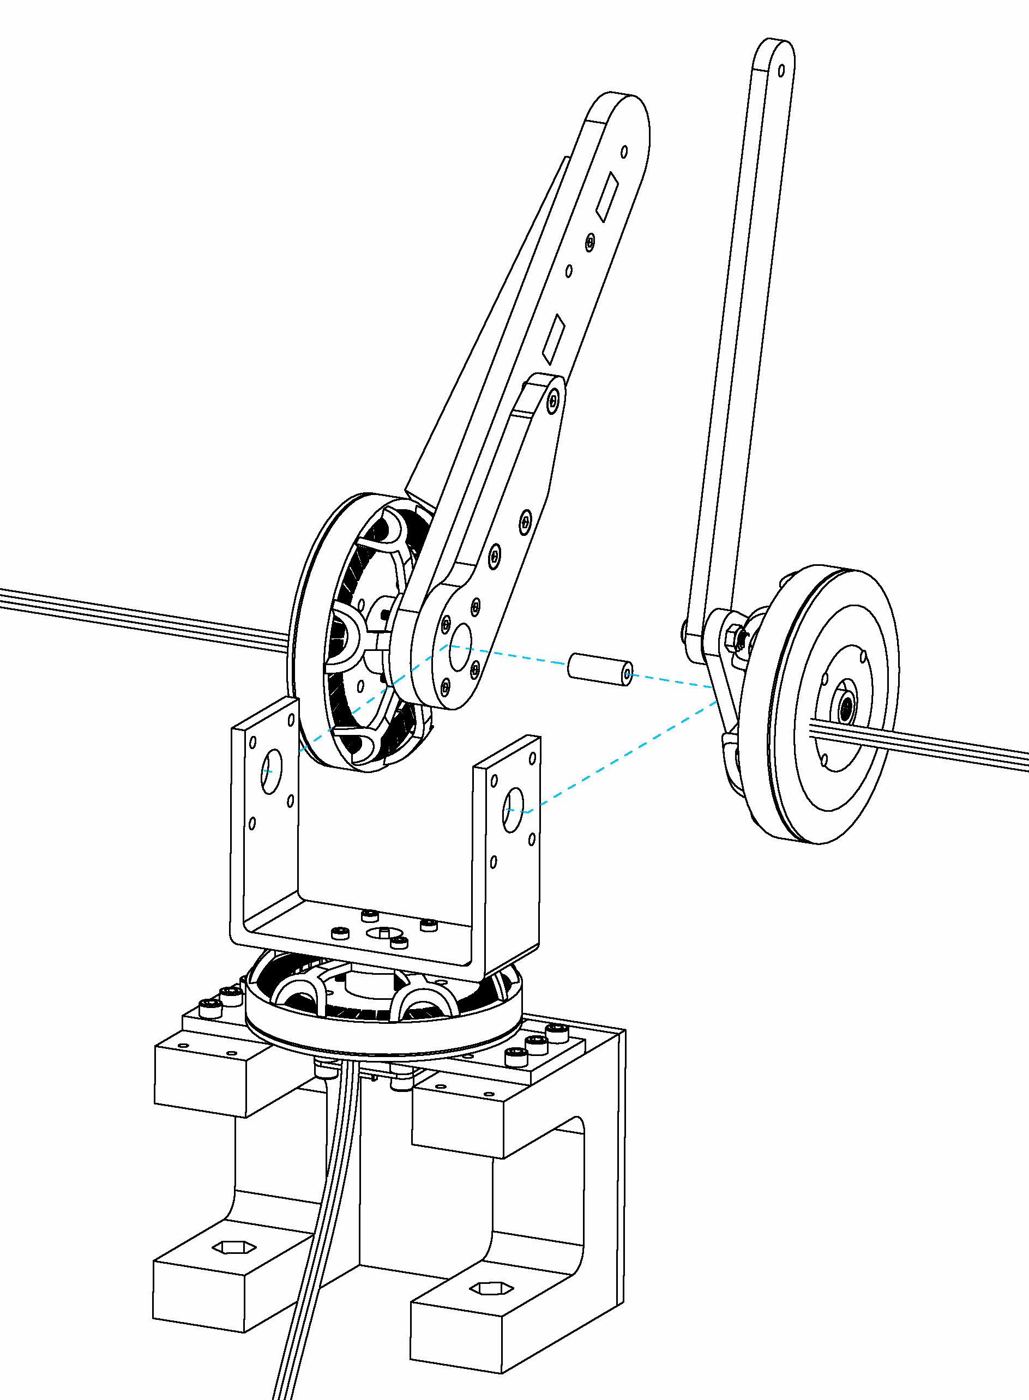
[picture p54: figure]

(Step 11) Finished:

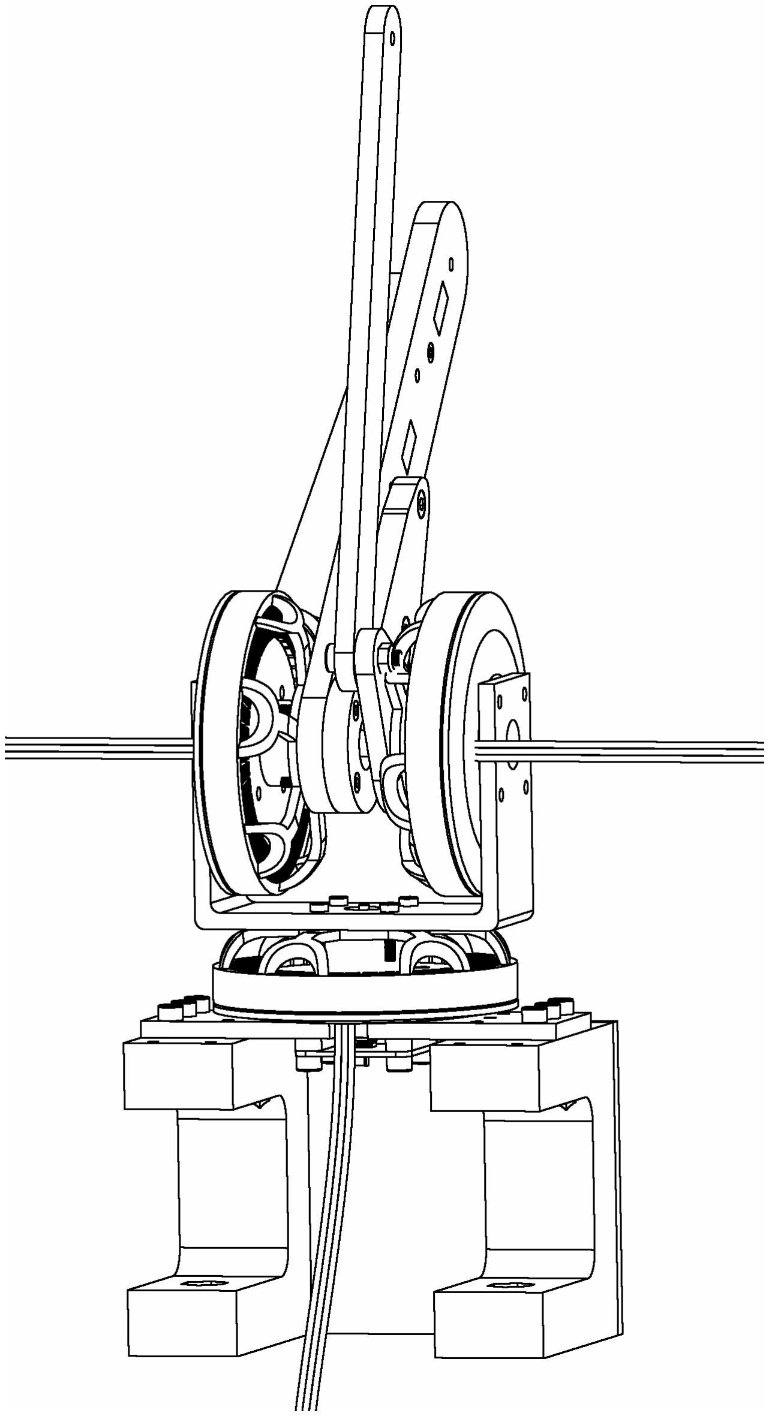
[picture p55: figure]

### Step 12, attach the encoders and motors to the shoulder bracket

- M4 16mm cap (x8)
- Part R (x2)
- Encoder Magnet (x2)
- Encoder (x2)

Directions (part 1):

- Screw encoder magnet into motor first

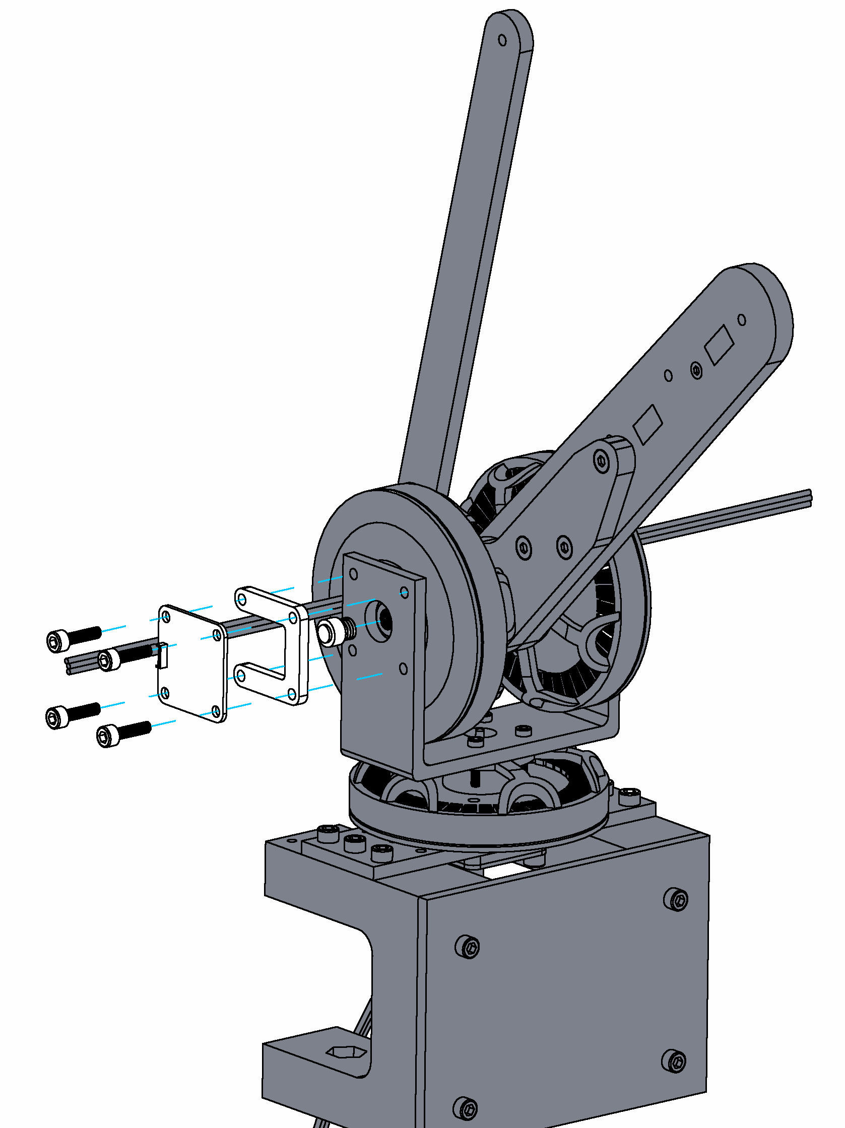
[picture p56: figure]

(Step 12) Directions (Part 2):

- Screw encoder magnet into motor first

(Step 12) Finished:

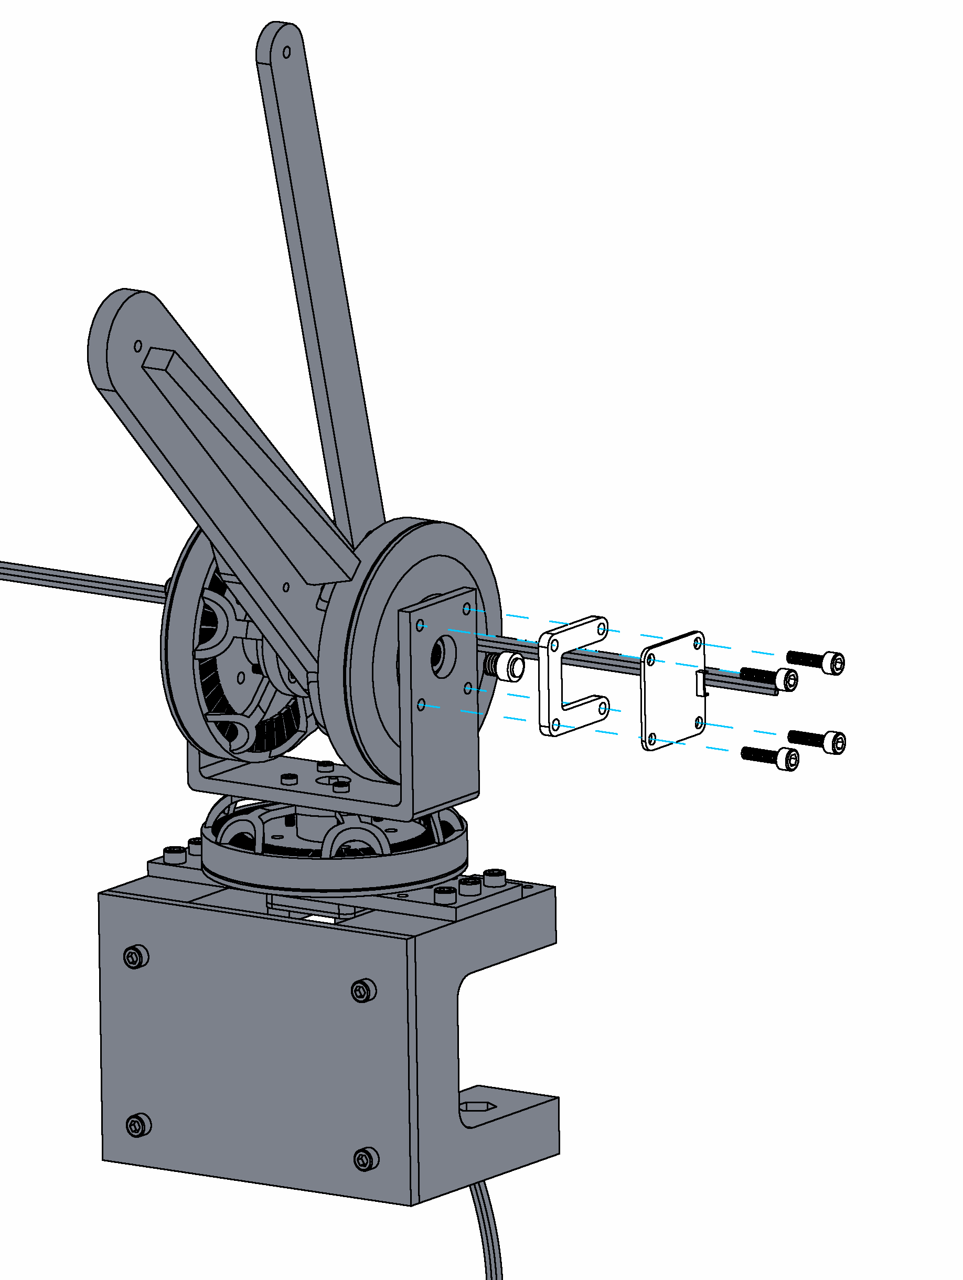
[picture p57: figure]

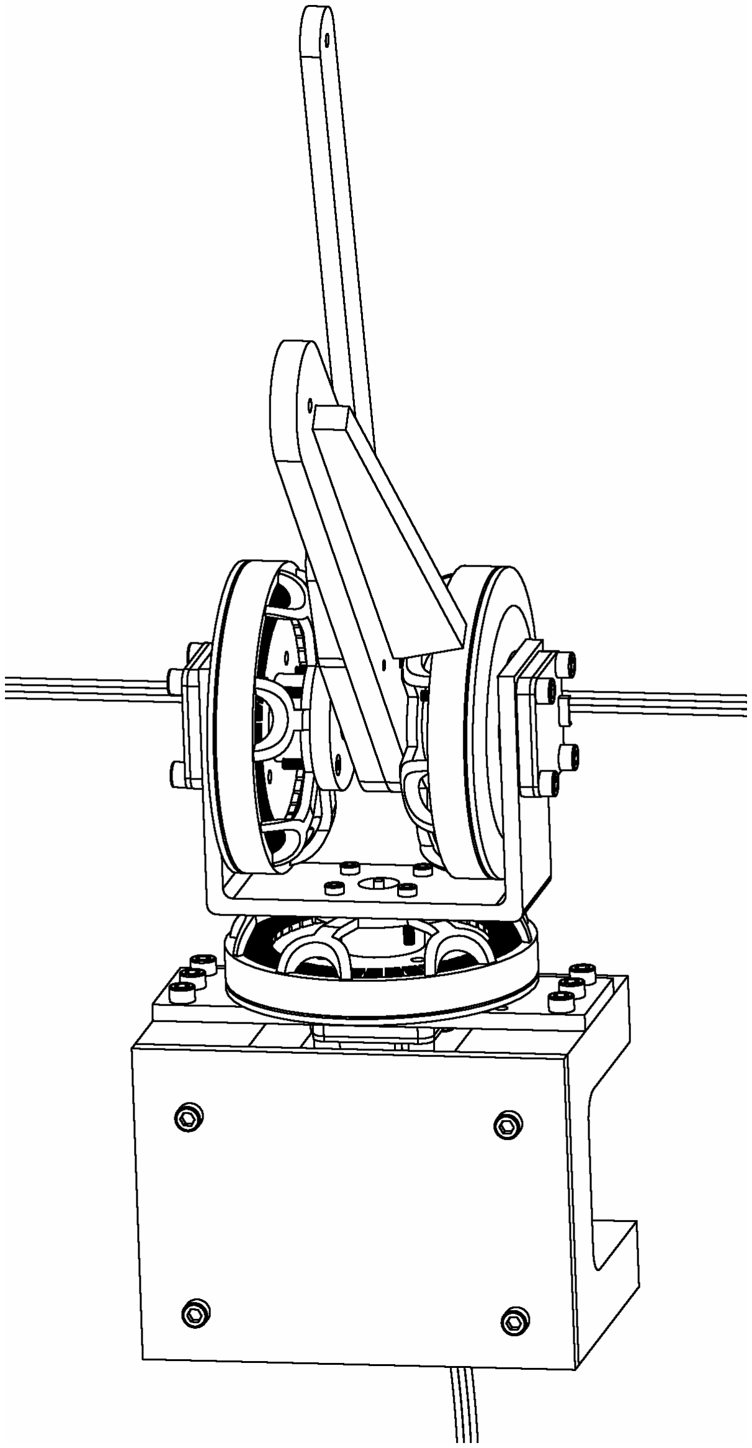
[picture p58: figure]

### Step 13, attach the arm end onto the main and parallel arm sections

- M5 18mm cap (x2)
- M5 Nyloc Nut (x2)

Directions:

The bolts should be as tight as possible without causing friction

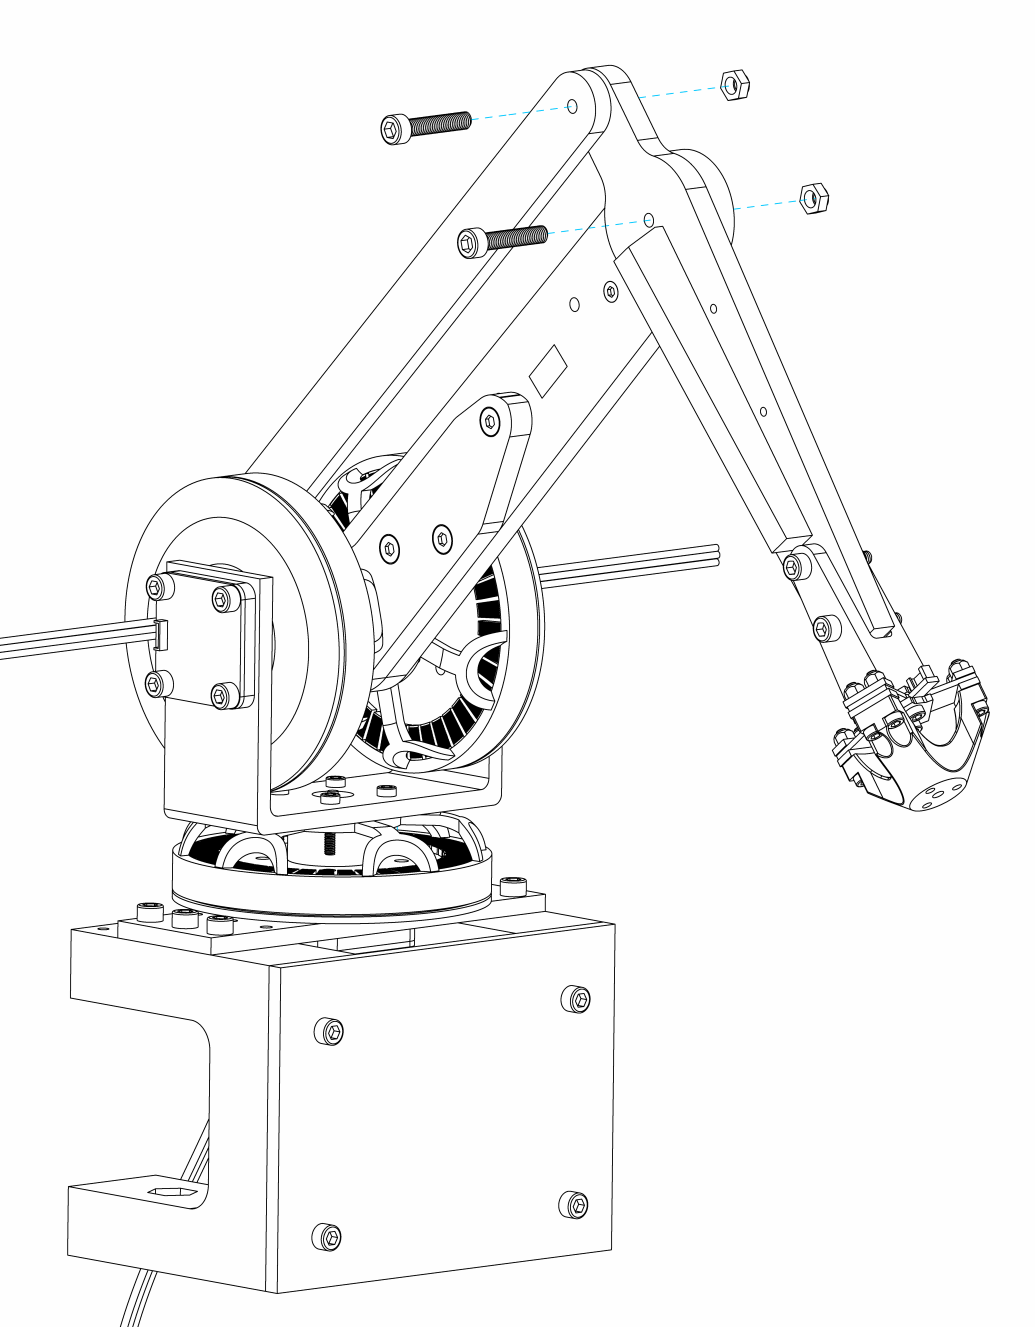
[picture p59: figure]

### Step 14, attach the main controller

- Main controller
- Part Q
- Bolt M3 15mm cap (x4)
- Nut M3 Nyloc (x4)
- Bolt M4 10mm cap (x2)

Directions:

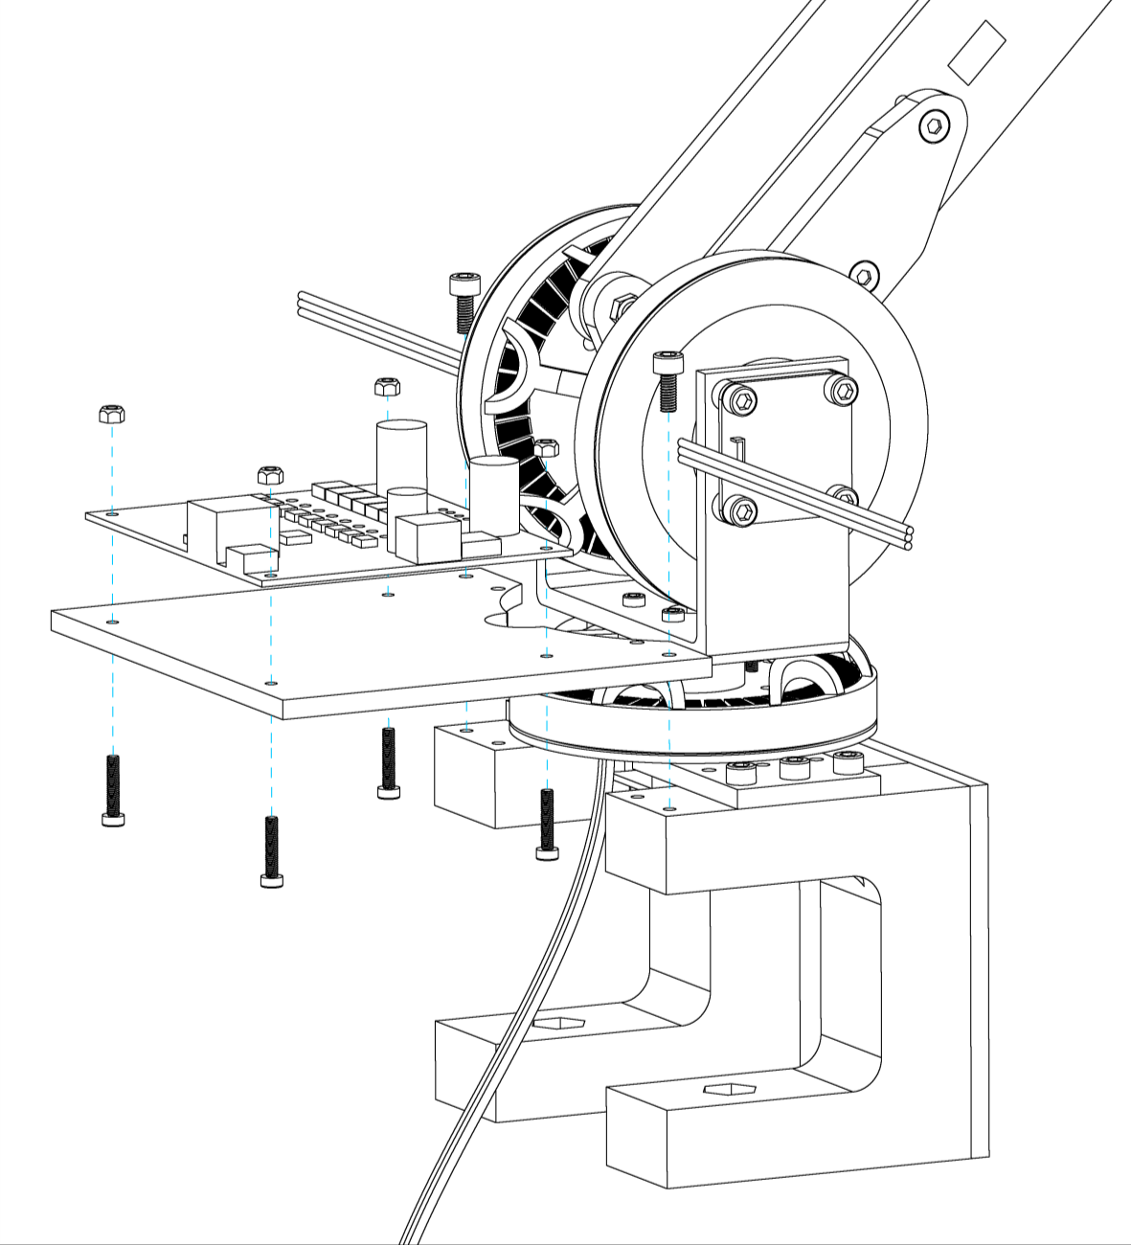
[picture p60: figure]

### Step 15, attach the force sensor controller

- Sensor controller
- Bolt M3 15mm cap (x2)
- Nut M3 Nyloc (x2)

Directions:

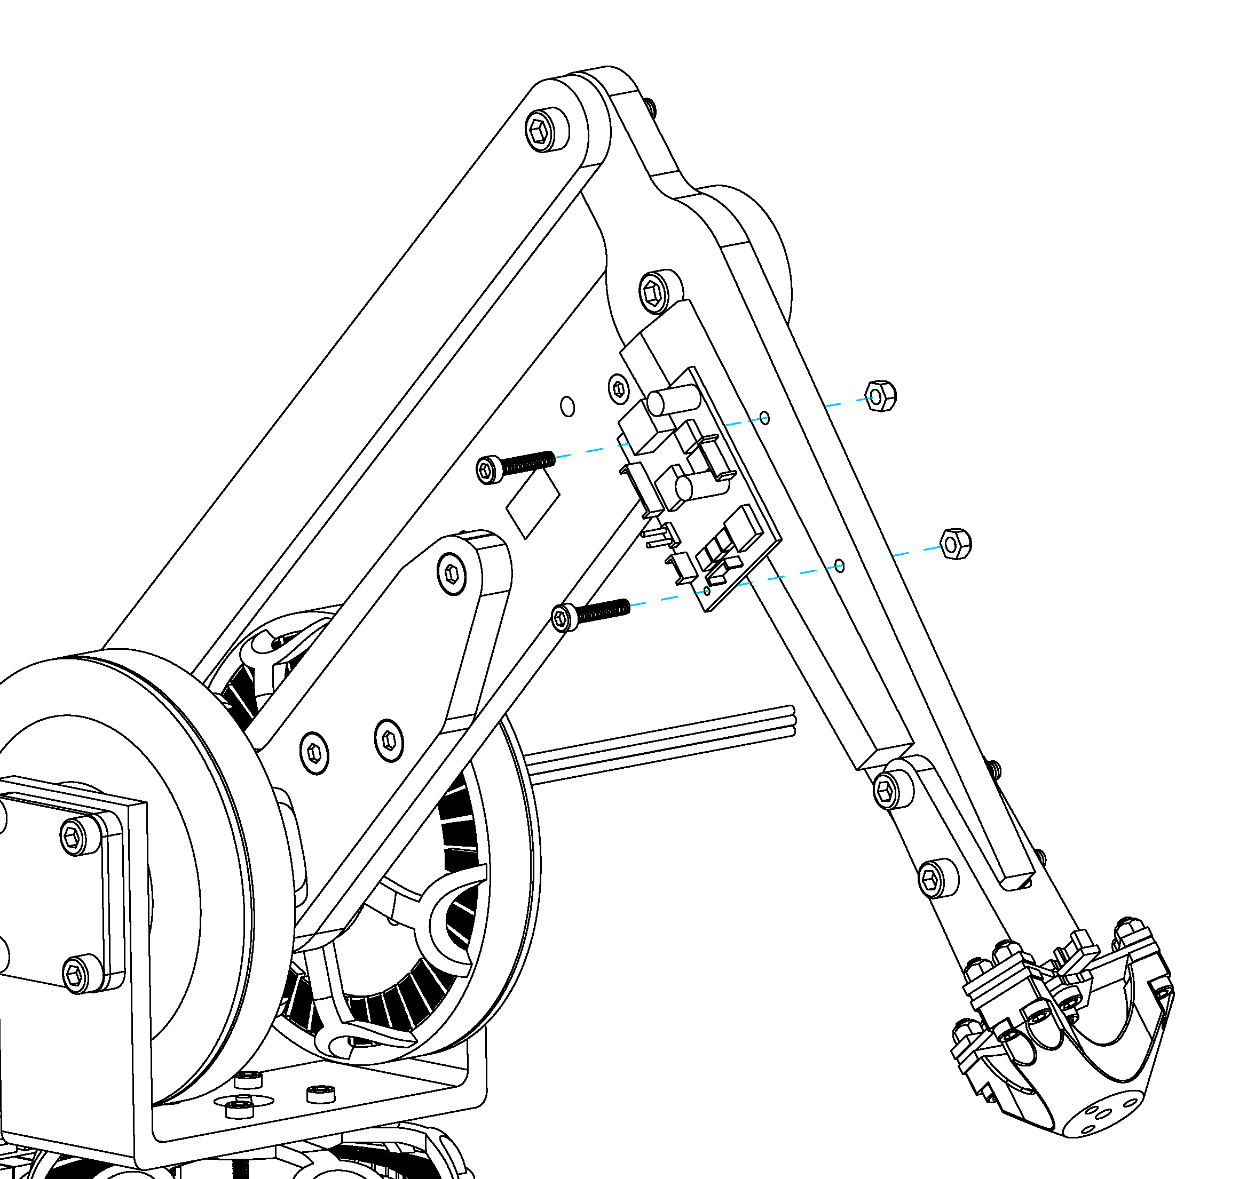
[picture p61: figure]

### Finished!
